tuyenubuntu/aicabinet/cabinet_cabin_1/Portal_Cabin_1/part_list_cabin1.xlsx

No. | Name | Part Number | Technical Doc | Brand or CO. | Unit | Qty/set | Qty cabin 1 | Spare part | Oder | Remark
1 | Sub 37 PIN board | DIN-37D-01 | DB37 Male | Adlink | PCS | 1 | 4 | 0 | 4
2 | D-Sub Cables | 976-ACL-10137-3MM | Cable 37 PIN | Adlink | PCS | 1 | 4 | 0 | 4
3 | Basler camera | a2A1920-51gcPRO | f 1/2.3" Effective Sensor Diagonal 7.9 mm | Basler | PCS | 1 | 4 | 0 | 4
4 | Cable GigE | 2200000622 | RJ-45, horizontal locking screws | Basler | PCS | 1 | 4 | 0 | 4
5 | Plug-in bridge | 3030161 | Plug-in bridge FBS 2-5, pitch: 5.2 mm, color: red | Phoenix contact | PCS | 10 | 40 | 0 | 50 | Minimum order quantity: 50
6 | Power supply unit | 2909575 | 24VDC, push | Phoenix contact | PCS | 1 | 4 | 0 | 4
7 | Relay | 2966728 | 24DC/48DC/100 Series Solid State Interface Relay, 28.8 V ac/dc Control, DIN Rail Mount | Phoenix contact | PCS | 4 | 16 | 3 | 13
8 | Terminal Blue | 3209523 | PT 2,5 BU - Feed-through terminal block | Phoenix contact | PCS | 2 | 8 | 0 | 1 box | Minimum order quantity: 50
9 | Terminal Gray | 3209510 | PT 2,5 - Feed-through terminal block | Phoenix contact | PCS | 17 | 68 | 0 | 2 box
10 | Terminal Pe | 3209536 | PT 2,5-PE - Ground terminal | Phoenix contact | PCS | 2 | 8 | 0 | 1 box
11 | End cover | 3030417 | color:Gray,D-ST 2,5 | Phoenix contact | PCS | 5 | 20 | 0 | 1 box
12 | End bracket | 3022218 | DIN rail, gray | Phoenix contact | PCS | 4 | 16 | 0 | 2 box
13 | Rail | 801733 | DIN Rail (2m) | Phoenix contact | m | 0.4 | 1.6 | 0 | 1 bar | 2m/bar
14 | Cable duct | 3240188 | CD 25X40 (2m) | Phoenix contact | m | 1.1 | 4.4 | 0 | 3 bar | 2m/bar
15 | Alamp/Signal | ST45L-BZ-2-24-RG | signalling column; LED; red/green; 24VDC; IP23 | QLINGHT | PCS | 1 | 4 | 2 | 2
16 | Circuit breaker | EZ9F34210 | MCB C10A | Schneider | PCS | 1 | 4 | 0 | 4
17 | Cabinet | NSYS3D3315P | 300x300x150 | Schnieder | PCS | 1 | 4 | 0 | 4
18 | Key Switch | 3SU1000-4BF01-0AA0 | key-operated switch, 22 mm, round, plastic, with 2 keys, 2 switch positions O-I, latching, actuating angle 90° | Siemens | PCS | 1 | 4 | 0 | 4
19 | Holder | 3SU1500-0AA10-0AA0 | 30,00 x 40,00 x 25,00 | Siemens | PCS | 1 | 4 | 0 | 4
20 | NO contact | 3SU1400-1AA10-1BA0 | 1 NO | Siemens | PCS | 1 | 4 | 0 | 5 | Minimun order quantity: 5
21 | Monitor |  |  |  | PCS | 1 | 4 | 0 | 4
22 | Vesa monitor |  |  |  | PCS | 1 | 4 | 0 | 4
