tuyenubuntu/aicabinet/cabinet_cabin_1/Component/board/board e.sldasm

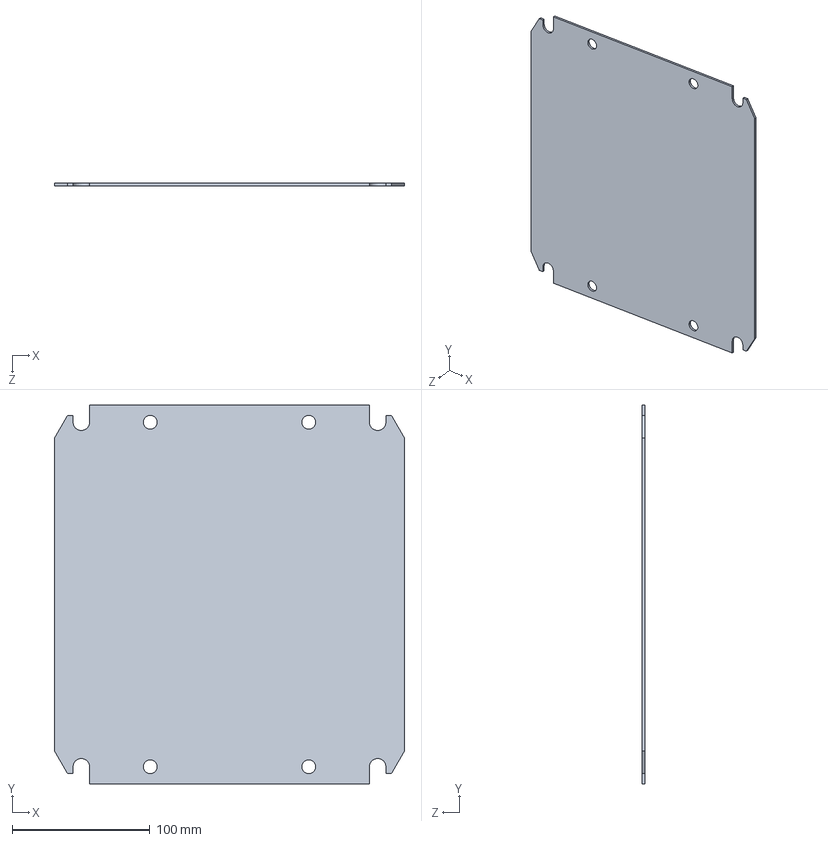
[picture p1: CAD file, 2024-05-25]
cabinet_cabin_1/Component/board/board e.sldasm
254.0 x 275.0 x 2.00 mm
