tuyenubuntu/aicabinet/cabinet_cabin_1/Component/Power_Supply/power supply.SLDASM

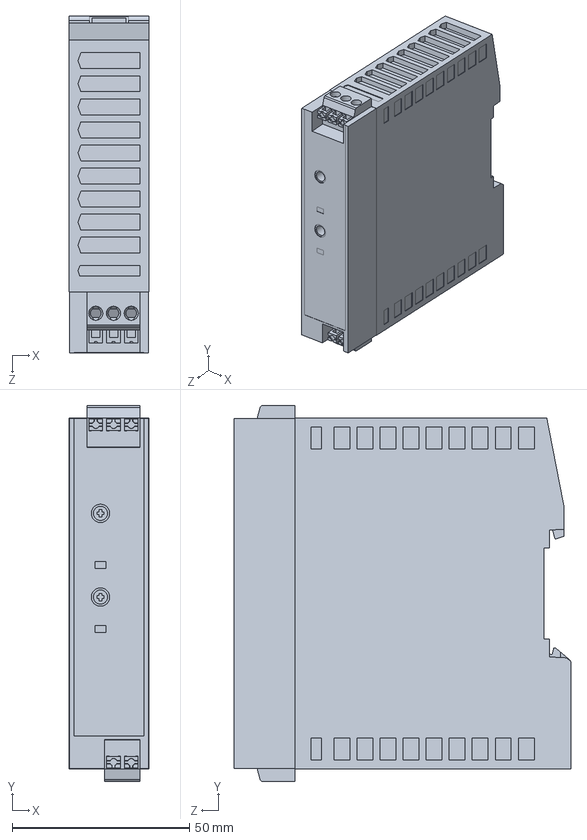
[picture p2: CAD file, 2024-05-25]
cabinet_cabin_1/Component/Power_Supply/power supply.SLDASM
22.5 x 106.0 x 95.0 mm
