tuyenubuntu/aicabinet/cabinet_cabin_1/Component/relay_soil/relay.SLDASM

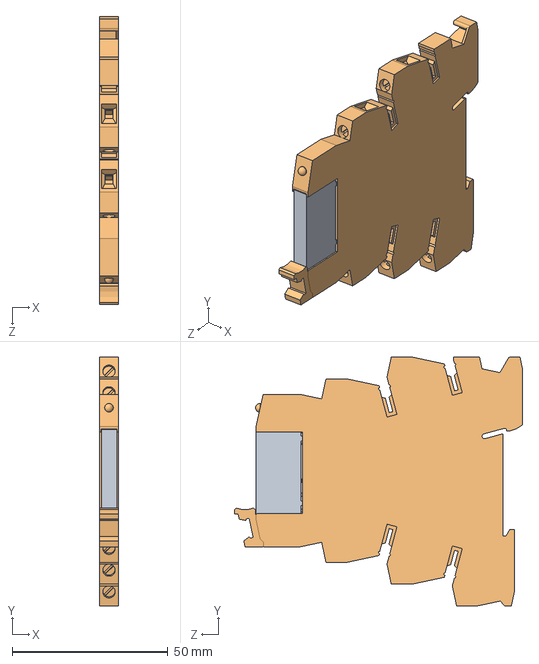
[picture p3: CAD file, 2024-05-25]
cabinet_cabin_1/Component/relay_soil/relay.SLDASM
6.10 x 80.0 x 92.6 mm
