tuyenubuntu/aicabinet/cabinet_cabin_1/Component/Sub_37_pin/DIN DB 37.SLDASM

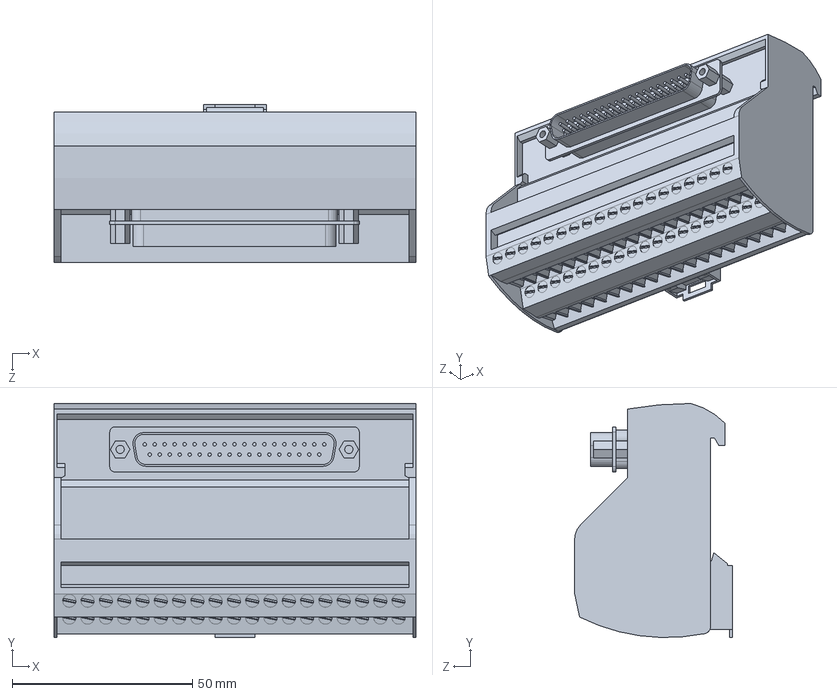
[picture p4: CAD file, 2024-05-25]
cabinet_cabin_1/Component/Sub_37_pin/DIN DB 37.SLDASM
100.5 x 65.0 x 43.8 mm
