tuyenubuntu/aicabinet/cabinet_cabin_1/Component/terminal_block/terminal_PE.SLDASM

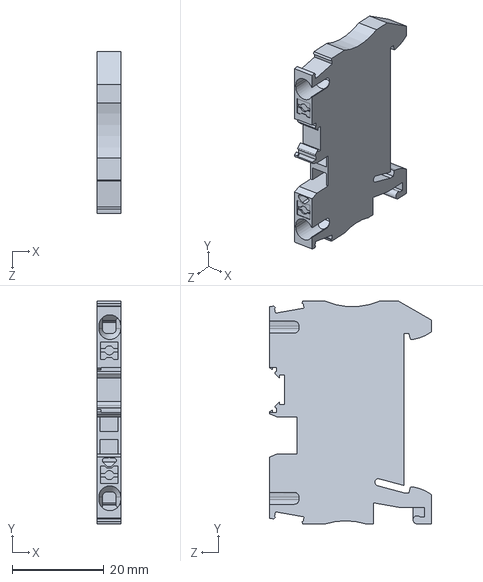
[picture p5: CAD file, 2024-05-25]
cabinet_cabin_1/Component/terminal_block/terminal_PE.SLDASM
5.15 x 48.6 x 35.3 mm
