tuyenubuntu/aicabinet/Cabinet_cabin_1_AL12/cabinet_AI_12.SLDASM

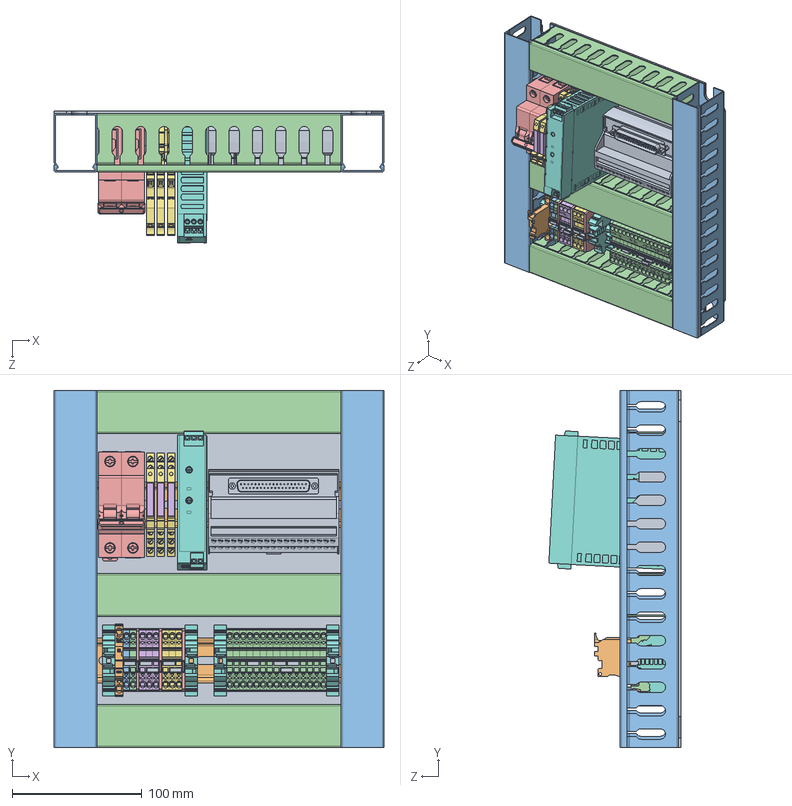
[picture p6: CAD file, 2024-05-25]
Cabinet_cabin_1_AL12/cabinet_AI_12.SLDASM
254.0 x 275.0 x 101.9 mm
AE_1036_500__2__3
DIN_rail x 2
cable_duct_275 x 2
cable_duct_188 x 3
Schneidr_MCB_C10A
2909575_PART1.stp
2900676_PART1.stp
3209510_PART1^3209510_terminal_gray
Copy of 3209510_PART1^cabinet_AI_12 x 16
end_cover x 3
Terminal_Bu x 3
terminalpe x 3
end x 4
jumper2.5 x 9
