tuyenubuntu/aicabinet/cabinet_cabin_1/cabinet/Drawing_prc/sheetdetail.SLDASM

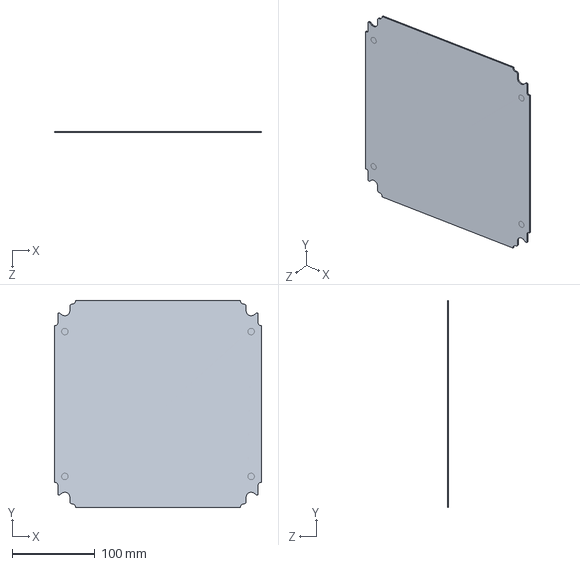
[picture p7: CAD file, 2024-05-25]
cabinet_cabin_1/cabinet/Drawing_prc/sheetdetail.SLDASM
250.0 x 250.0 x 1.80 mm
