tuyenubuntu/aicabinet/cabinet_cabin_1/cabinet/NSYS3D3315P_3D.SLDASM

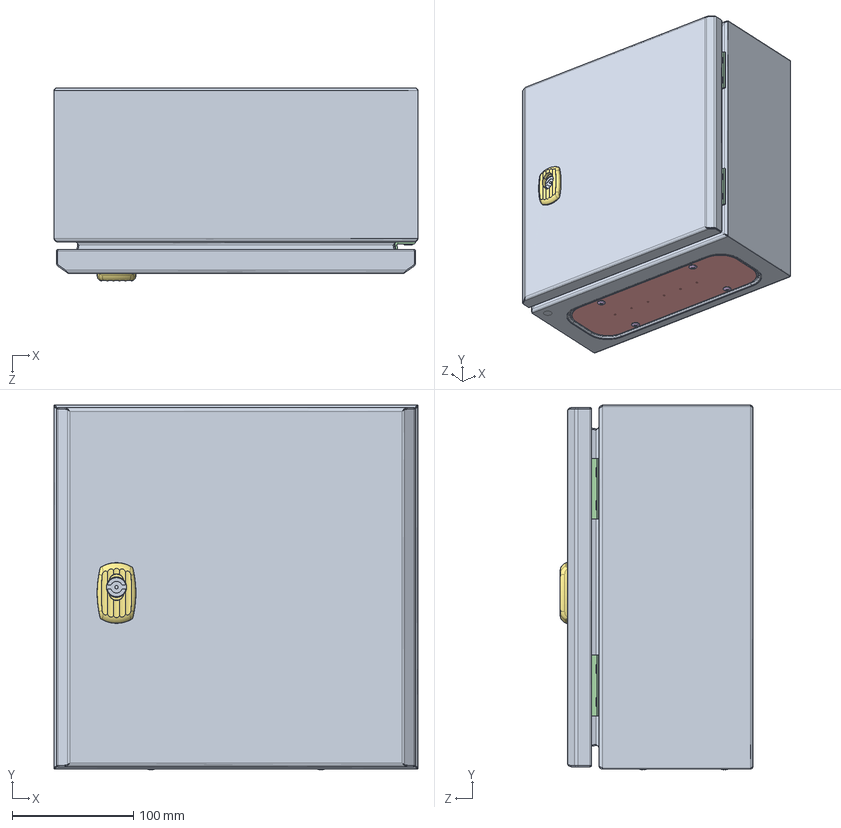
[picture p8: CAD file, 2024-05-25]
cabinet_cabin_1/cabinet/NSYS3D3315P_3D.SLDASM
300.0 x 300.5 x 159.0 mm
51140584-S_300X300X150_1LAST_VE_AF0.stp
51140583-S01_1LAST_VERSION_1__3_AF8.stp
51140583-S01_1LAST_VERSION_1__3_AF9.stp
51140583-S01_1LAST_VERSION_1__3_AF10.stp
51140583-S01_1LAST_VERSION_1__3_AF11.stp
51140582-S01_1LAST_VERSION_1__7.stp x 3
ENN4584AS_300X300_1LAST_VERSION.stp
ENN2538A_M6X17_1LAST_VERSION__7.stp
51140547-S_300X300_1LAST_VERSIO.stp
51140547-S1_300X300_1LAST_VERSI.stp
51140590-S_1LAST_VERSION_1_2.stp x 2
ENN0059A-S_1LAST_VERSION_1_2__7.stp x 2
51140599_PPC245X80_1LAST_VERSIO.stp
ENN5120805644_1LAST_VERSION_1_7.stp x 4
51140856-SIMP_1LAST_VERSION_1_7.stp
ENN0052A-SIMP_1LAST_VERSION_1_7.stp
ENN0263A-SIMP_1LAST_VERSION_1_7.stp
ENN0284A-SIMP_1LAST_VERSION_1_7.stp
ENN0827A-SIMP_1LAST_VERSION_1_7.stp
ENN5120807239-SIMP_1LAST_VERS_7.stp
