tuyenubuntu/aicabinet/cabinet_cabin_1/Component/board/M16 x 1.5 Cable Gland Assembly.stp

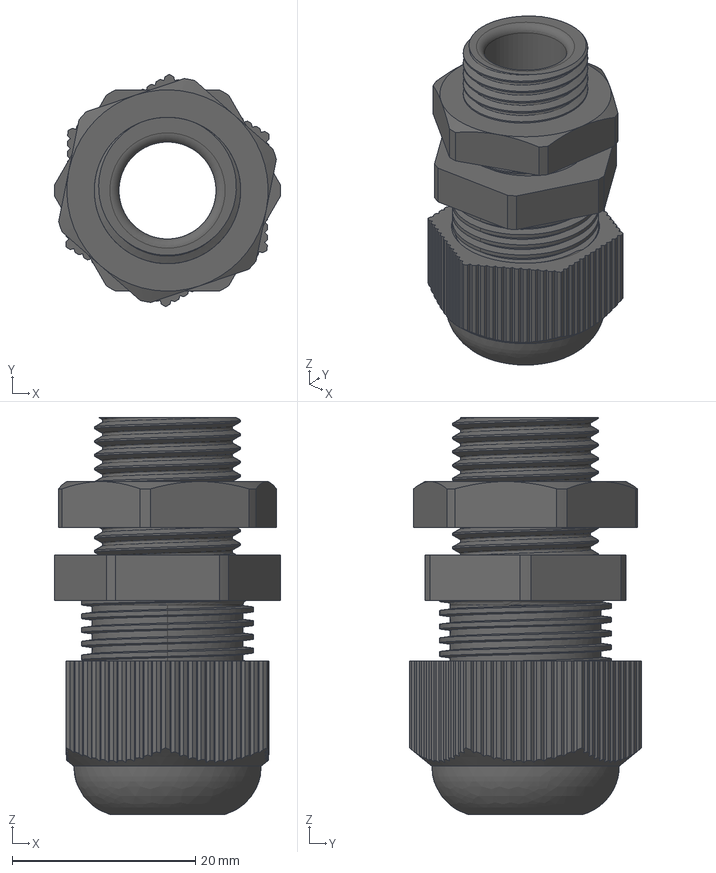
[picture p9: CAD file, 2024-05-25]
cabinet_cabin_1/Component/board/M16 x 1.5 Cable Gland Assembly.stp
24.7 x 25.4 x 43.4 mm
Nut
Compression Nut
