tuyenubuntu/aicabinet/cabinet_cabin_1/Component/Circuit_breaker/MCBA10.SLDASM

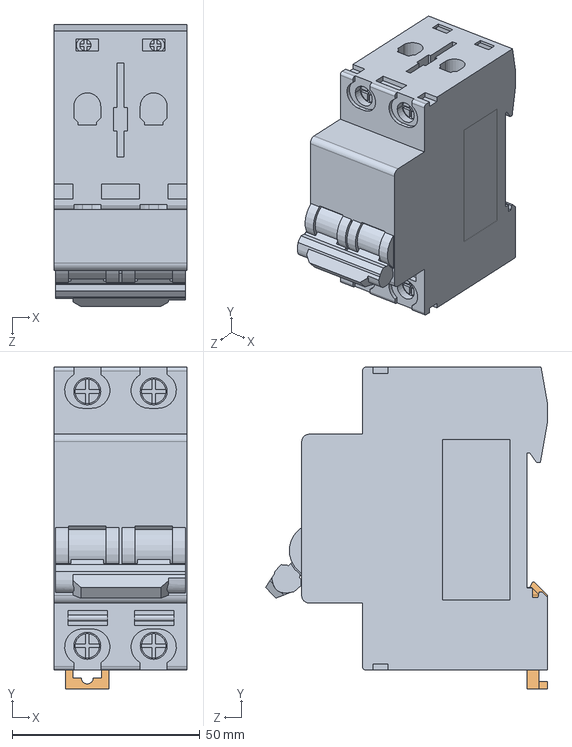
[picture p10: CAD file, 2024-05-25]
cabinet_cabin_1/Component/Circuit_breaker/MCBA10.SLDASM
35.4 x 85.8 x 75.1 mm
EZ9F32240.stp
EZ9F32240-1.stp
