tuyenubuntu/aicabinet/Mount_camera/Mount_camera_OD/asb.SLDASM

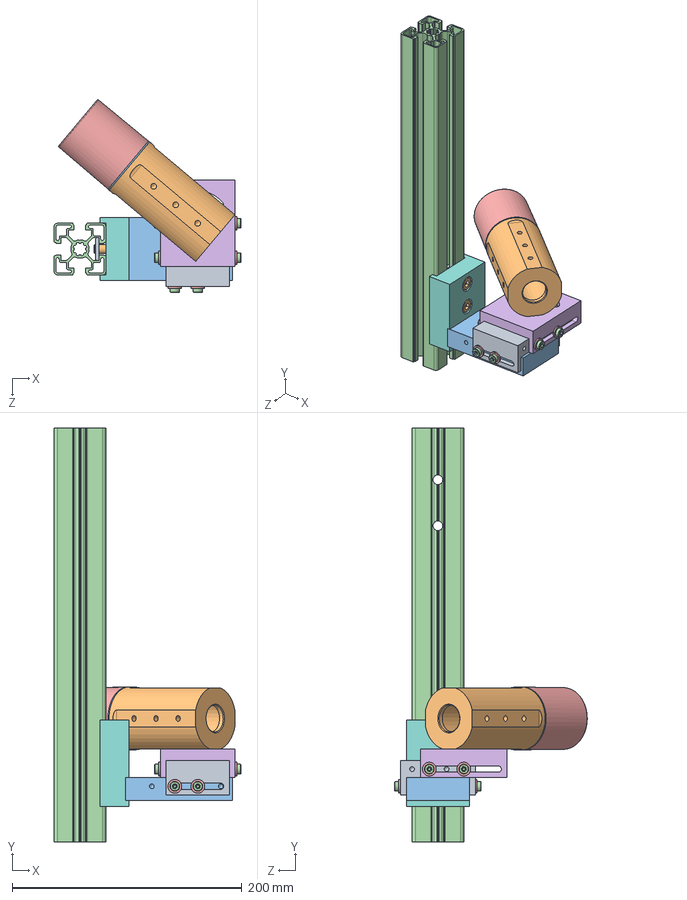
[picture p11: CAD file, 2024-05-25]
Mount_camera/Mount_camera_OD/asb.SLDASM
162.5 x 360.0 x 167.5 mm
IPE Compact Housing Body Long_CG.step
D55 seal.step
Perfil 45X45_Long
2200000710 Basler IP-Housing Lens Tube 50mm
DIN 6912 - M6 x 10 --- 4.5N x 2
Part1ip
nut x 2
DIN 6912 - M8 x 25 --- 18N x 2
Part1ipp
DIN 6912 - M5 x 10 --- 5.8N x 8
DIN 6902-A5.5 x 8
