tuyenubuntu/aicabinet/Cabinet_cabin_1_AL12/Component/terminal_block/shiel.SLDASM

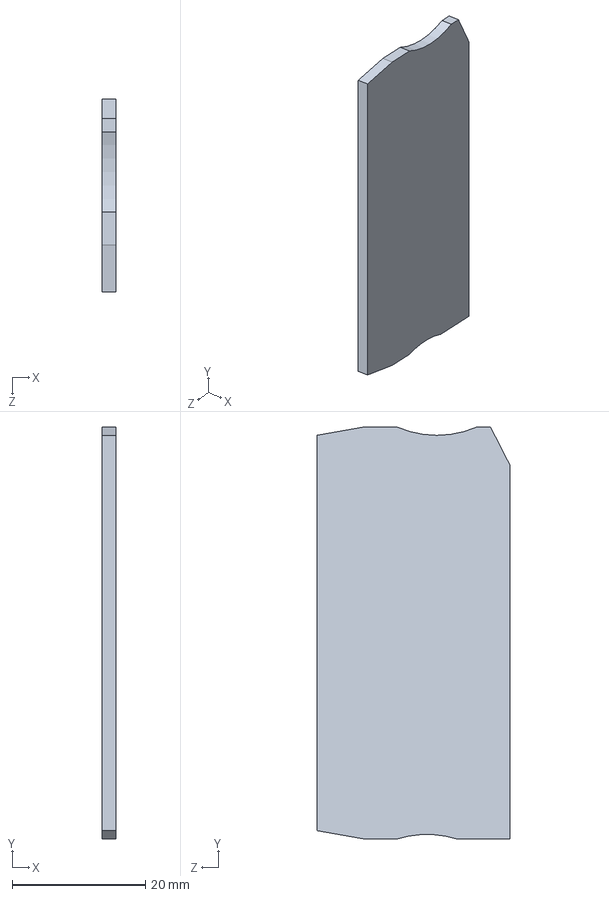
[picture p12: CAD file, 2024-05-25]
Cabinet_cabin_1_AL12/Component/terminal_block/shiel.SLDASM
2.10 x 61.9 x 29.0 mm
