tuyenubuntu/aicabinet/cabinet_cabin_1/Component/terminal_block/jumper.SLDASM

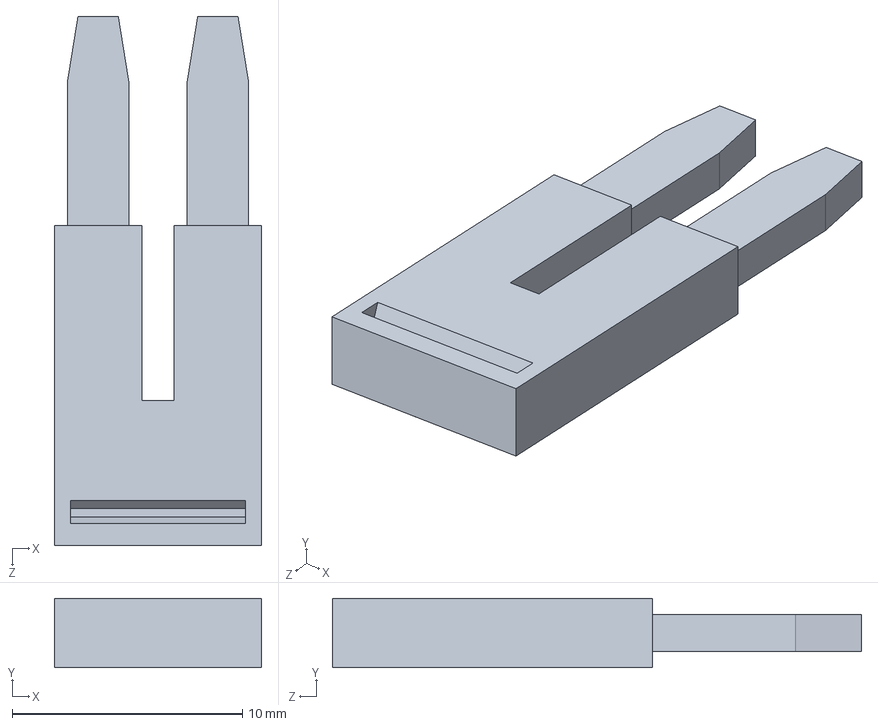
[picture p13: CAD file, 2024-05-25]
cabinet_cabin_1/Component/terminal_block/jumper.SLDASM
9.00 x 3.00 x 23.0 mm
