tuyenubuntu/aicabinet/Mount_camera/Mount_camera_OD/Mount_camera.SLDASM

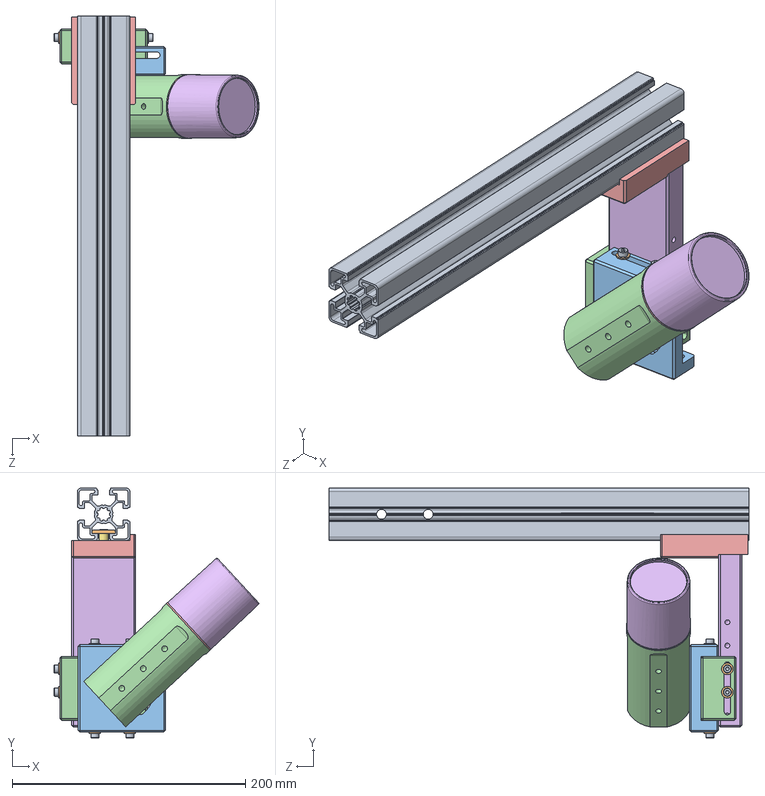
[picture p14: CAD file, 2024-05-25]
Mount_camera/Mount_camera_OD/Mount_camera.SLDASM
175.6 x 214.2 x 360.0 mm
part5ip
nut x 2
IPE Compact Housing Body Long_CG.step
D55 seal.step
2200000710 Basler IP-Housing Lens Tube 50mm
DIN 912 M8 x 16 --- 16N x 2
DIN 912 M6 x 12 --- 12N x 2
DIN 912 M4 x 16 --- 16N x 8
DIN 6902-A4.55 x 8
BS EN ISO 4762 M6 x 25 - 25N x 2
