tuyenubuntu/aicabinet/cabinet_cabin_1/AL_OG/M16 x 1.5 Cable Gland Assembly.stp.SLDPRT

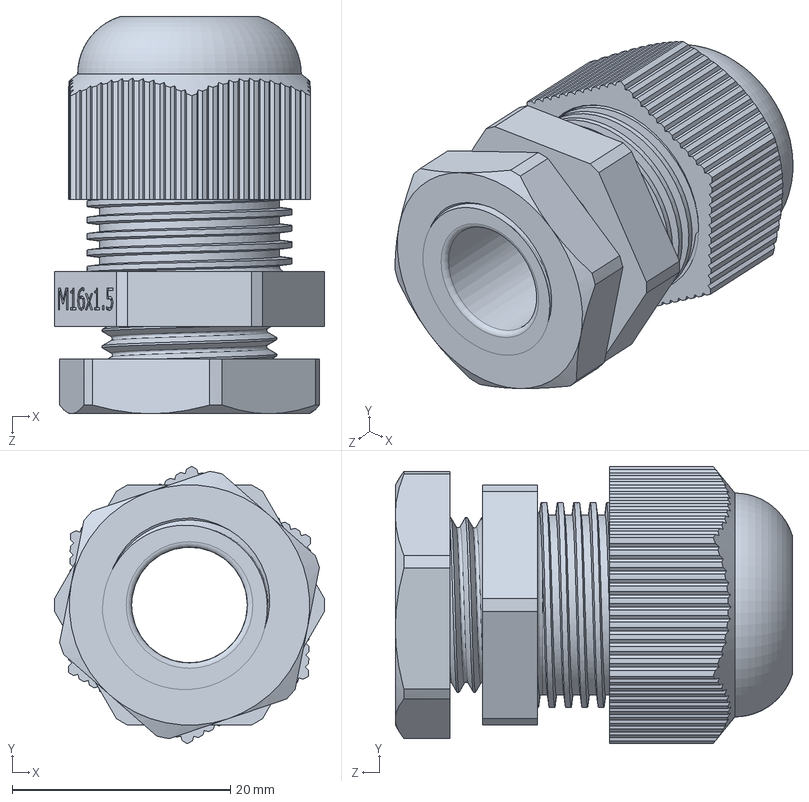
[picture p15: CAD file, 2024-05-25]
cabinet_cabin_1/AL_OG/M16 x 1.5 Cable Gland Assembly.stp.SLDPRT
24.7 x 25.4 x 36.4 mm
