tuyenubuntu/aicabinet/Cabinet_cabin_1_AL12/env/cabinet AI Camera layout.SLDASM

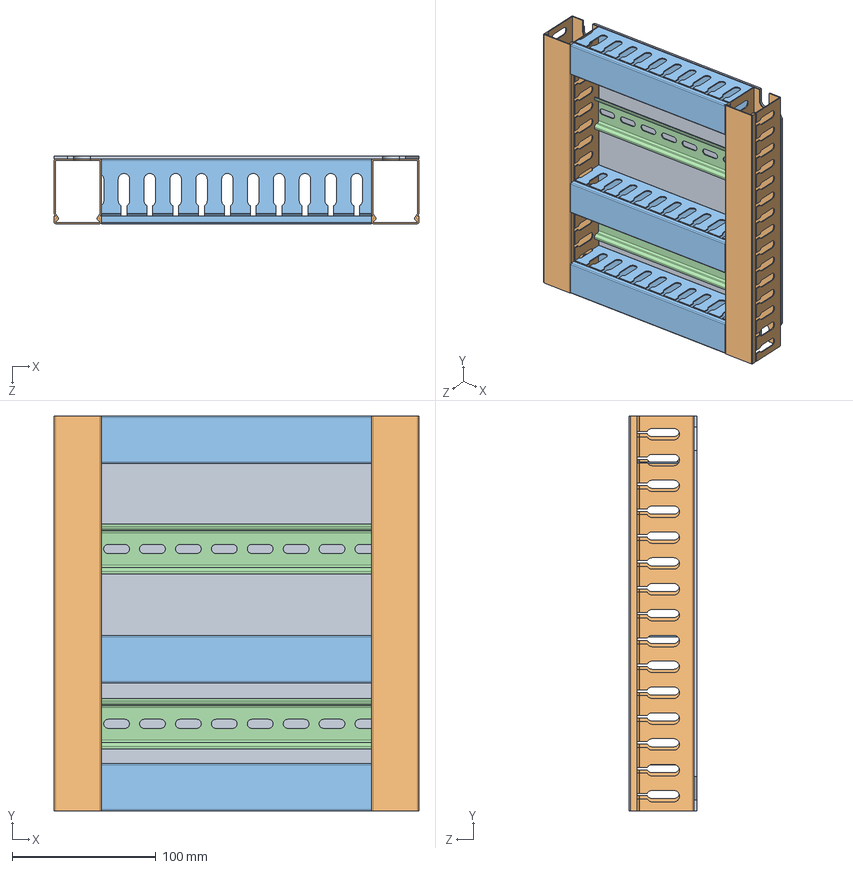
[picture p16: CAD file, 2024-05-25]
Cabinet_cabin_1_AL12/env/cabinet AI Camera layout.SLDASM
254.0 x 275.0 x 47.0 mm
AE_1036_500__2__3
cable duct long x 2
cable duct short x 3
DIN_rail x 2
