tuyenubuntu/aicabinet/cabinet_cabin_1/Component/Circuit_breaker/cb sh.SLDPRT

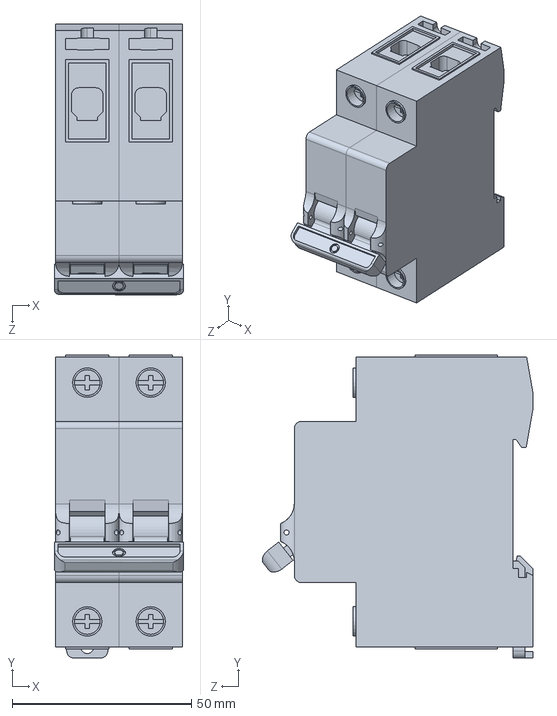
[picture p17: CAD file, 2024-05-25]
cabinet_cabin_1/Component/Circuit_breaker/cb sh.SLDPRT
36.0 x 84.5 x 75.4 mm
