tuyenubuntu/aicabinet/cabinet_cabin_1/Component/Rail/Riel Din500mm.SLDPRT

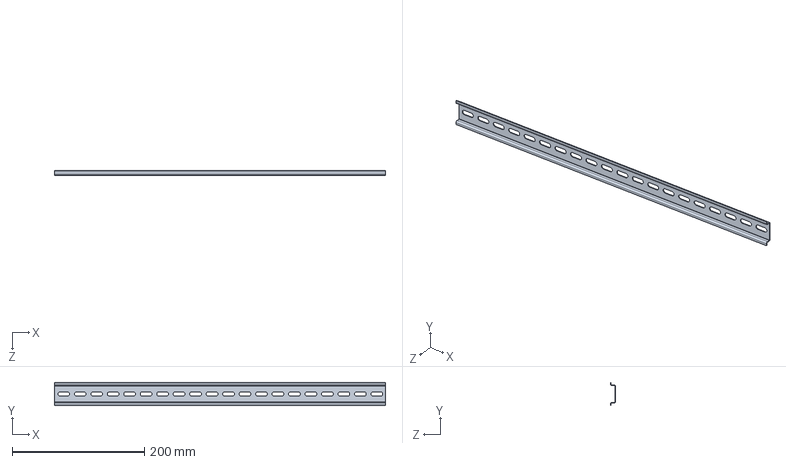
[picture p18: CAD file, 2024-05-25]
cabinet_cabin_1/Component/Rail/Riel Din500mm.SLDPRT
500.0 x 35.0 x 7.50 mm
