tuyenubuntu/aicabinet/Cabinet_cabin_1_AL12/Component/Cable_duct/MD-1.5L-1.7-R.SLDPRT

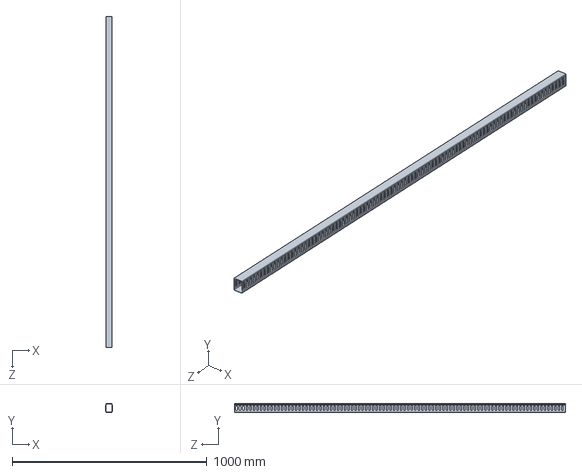
[picture p19: CAD file, 2024-05-25]
Cabinet_cabin_1_AL12/Component/Cable_duct/MD-1.5L-1.7-R.SLDPRT
33.0 x 45.0 x 1700.0 mm
