tuyenubuntu/aicabinet/Cabinet_cabin_1_AL12/Component/Rail_DIN/DIN_rail.SLDPRT

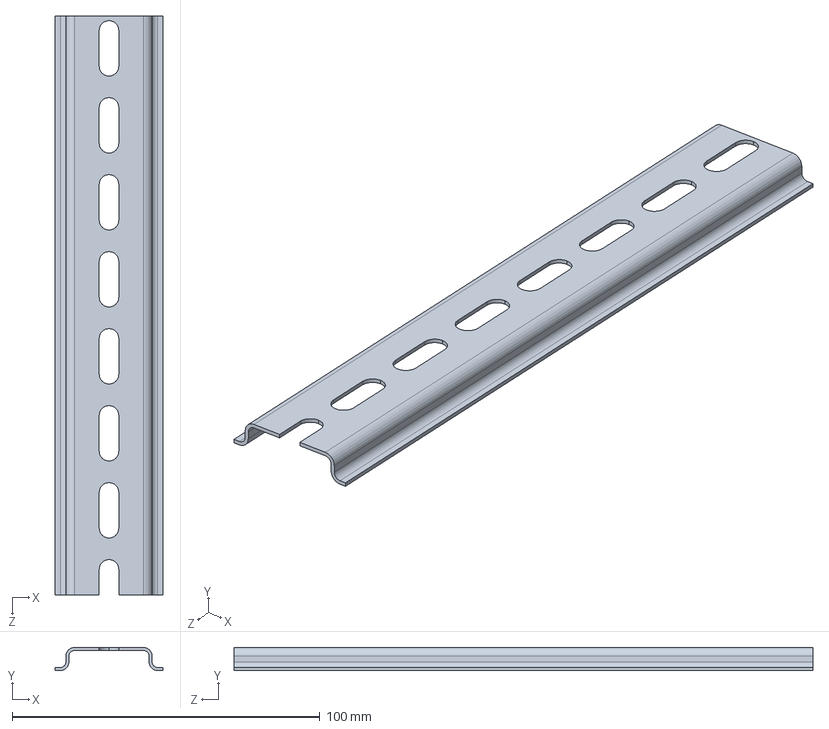
[picture p20: CAD file, 2024-05-25]
Cabinet_cabin_1_AL12/Component/Rail_DIN/DIN_rail.SLDPRT
35.0 x 7.50 x 188.0 mm
