tuyenubuntu/aicabinet/Mount_camera/Mount_camera_FN/Part3.SLDPRT

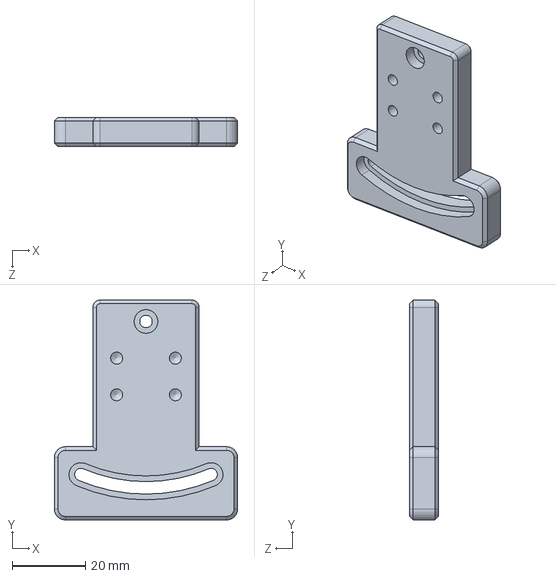
[picture p21: CAD file, 2024-05-25]
Mount_camera/Mount_camera_FN/Part3.SLDPRT
50.0 x 60.0 x 8.00 mm
