tuyenubuntu/aicabinet/Mount_camera/Mount_camera_OD/part1.SLDPRT

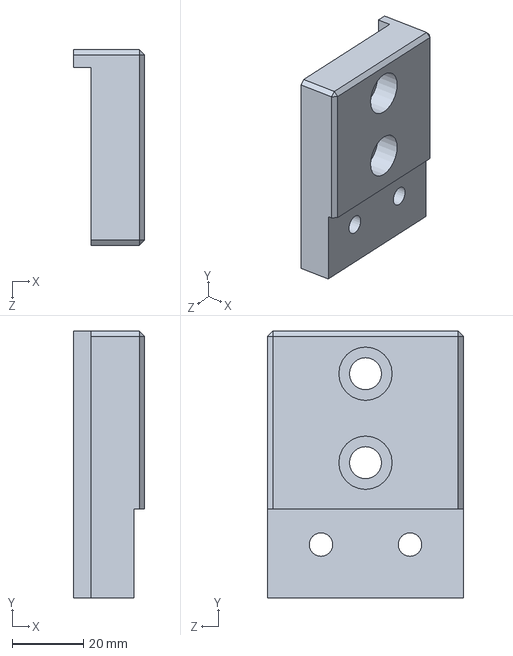
[picture p22: CAD file, 2024-05-25]
Mount_camera/Mount_camera_OD/part1.SLDPRT
20.0 x 75.0 x 55.0 mm
