tuyenubuntu/aicabinet/cabinet_cabin_1/Component/Rail/Riel Din200mm.SLDPRT

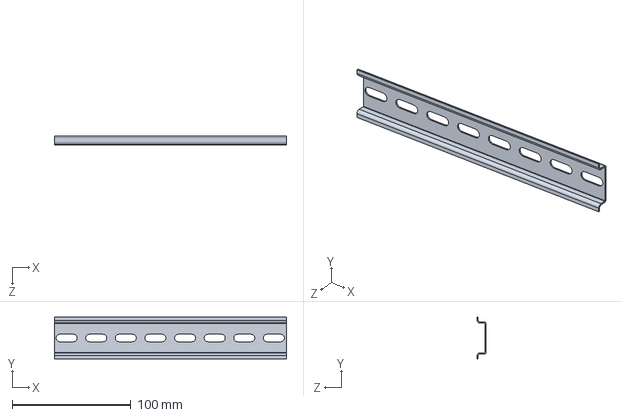
[picture p23: CAD file, 2024-05-25]
cabinet_cabin_1/Component/Rail/Riel Din200mm.SLDPRT
195.0 x 35.0 x 7.50 mm
