tuyenubuntu/aicabinet/cabinet_cabin_1/Component/terminal_block/end_cover.SLDPRT

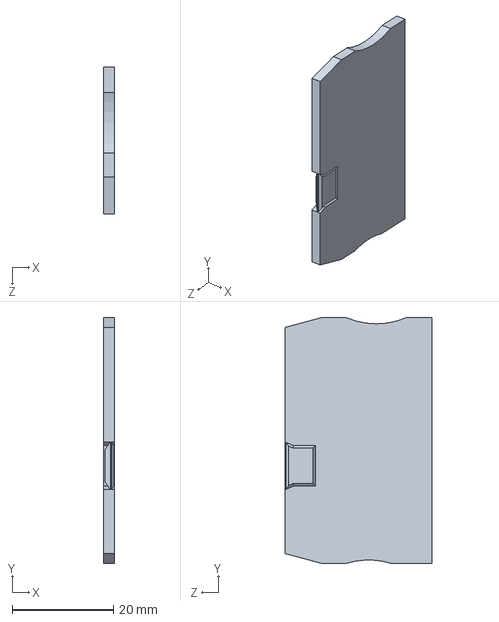
[picture p24: CAD file, 2024-05-25]
cabinet_cabin_1/Component/terminal_block/end_cover.SLDPRT
2.20 x 48.6 x 29.0 mm
