tuyenubuntu/aicabinet/Cabinet_cabin_1_AL12/Component/Cable_duct/cable_duct_188.SLDPRT

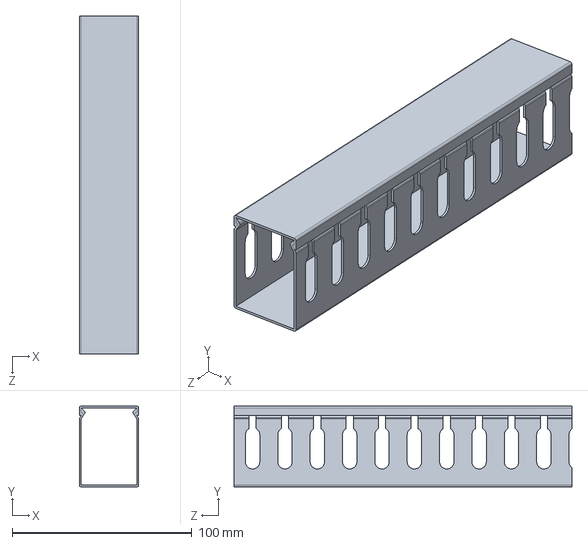
[picture p25: CAD file, 2024-05-25]
Cabinet_cabin_1_AL12/Component/Cable_duct/cable_duct_188.SLDPRT
33.0 x 45.0 x 188.0 mm
