tuyenubuntu/aicabinet/Cabinet_cabin_1_AL12/Component/terminal_block/terminalpe.SLDPRT

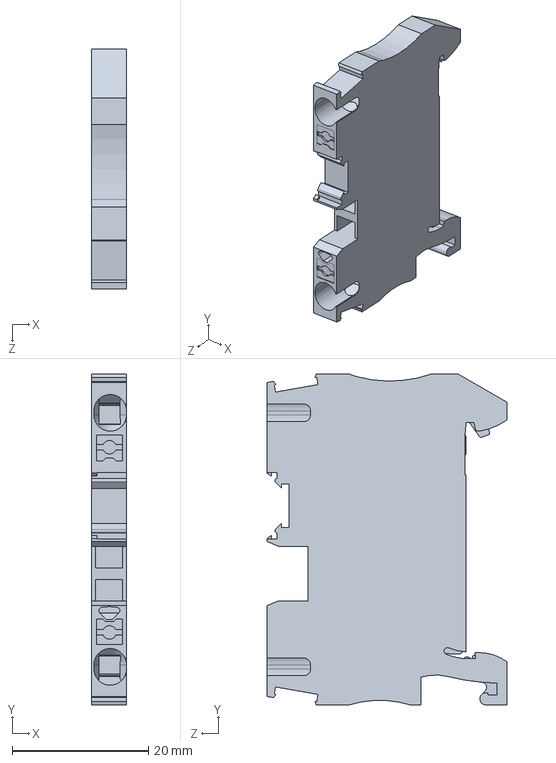
[picture p26: CAD file, 2024-05-25]
Cabinet_cabin_1_AL12/Component/terminal_block/terminalpe.SLDPRT
5.15 x 48.6 x 35.2 mm
