tuyenubuntu/aicabinet/Cabinet_cabin_1_AL12/env/cable duct long.SLDPRT

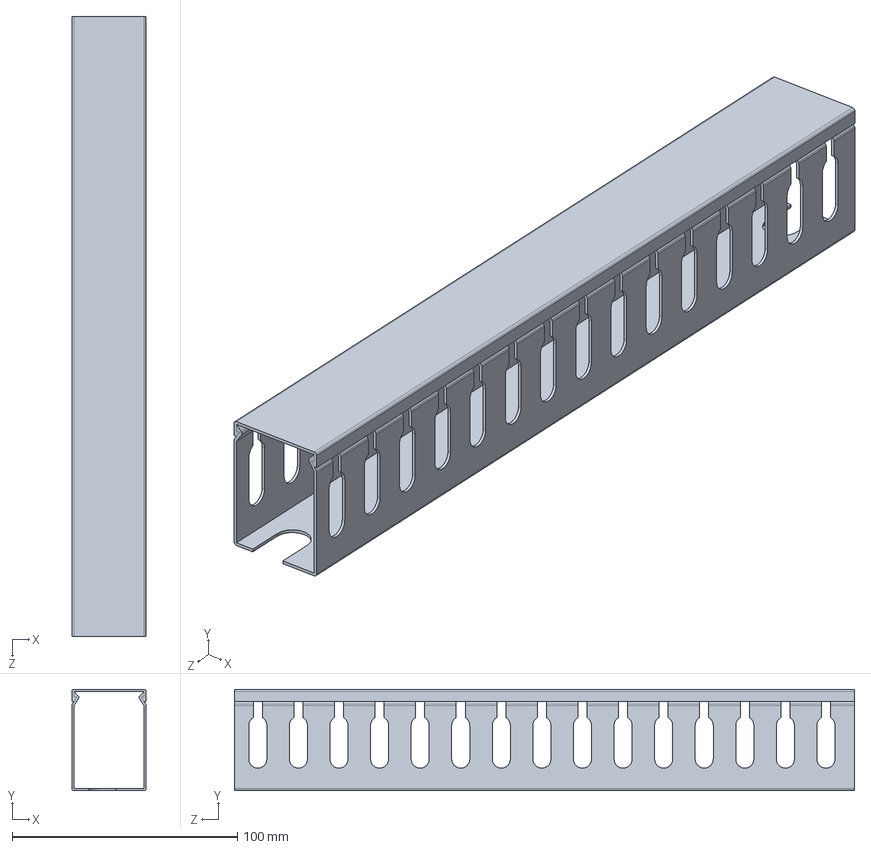
[picture p27: CAD file, 2024-05-25]
Cabinet_cabin_1_AL12/env/cable duct long.SLDPRT
33.0 x 45.0 x 275.0 mm
