tuyenubuntu/aicabinet/Mount_camera/Mount_camera_FN/Part2.SLDPRT

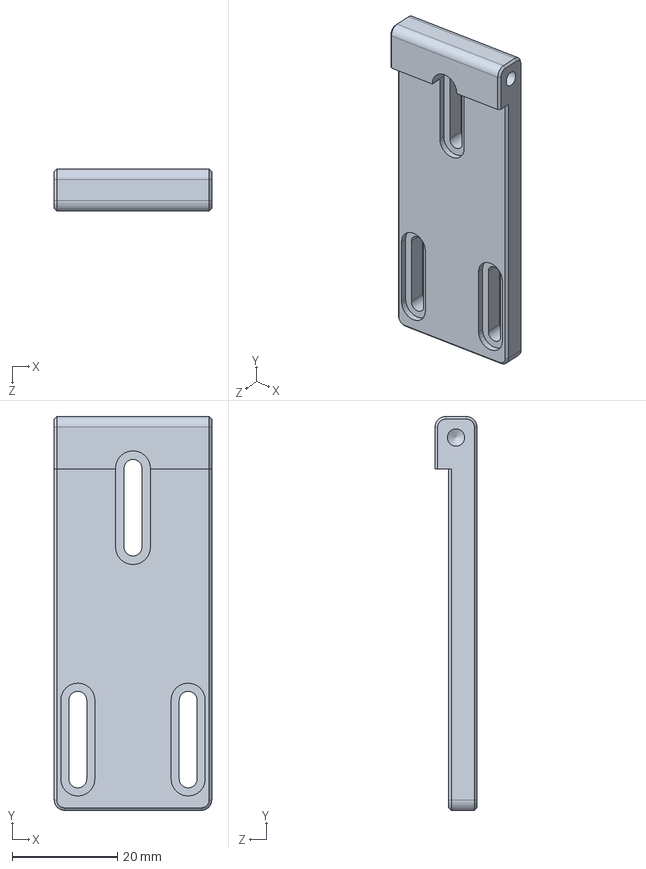
[picture p28: CAD file, 2024-05-25]
Mount_camera/Mount_camera_FN/Part2.SLDPRT
30.0 x 75.0 x 8.00 mm
