tuyenubuntu/aicabinet/cabinet_cabin_1/AL_OG/sheet_metalr.SLDPRT

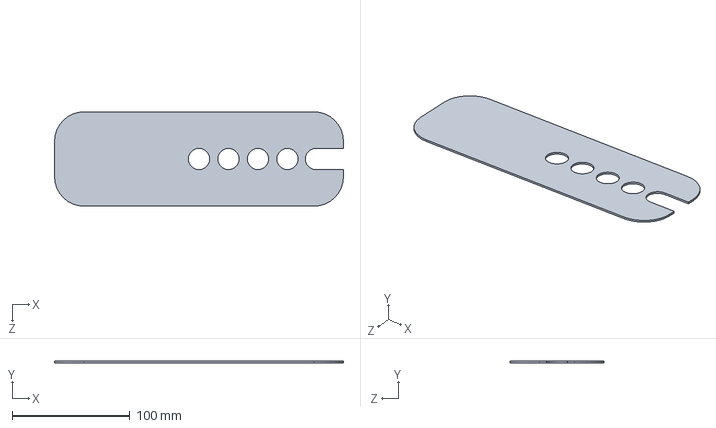
[picture p29: CAD file, 2024-05-25]
cabinet_cabin_1/AL_OG/sheet_metalr.SLDPRT
245.0 x 1.50 x 80.0 mm
