tuyenubuntu/aicabinet/cabinet_cabin_1/Component/board/pxc_1050017_01_00_ZB-5-LGS-FORTL-ZAHLEN_3D.stp.SLDPRT

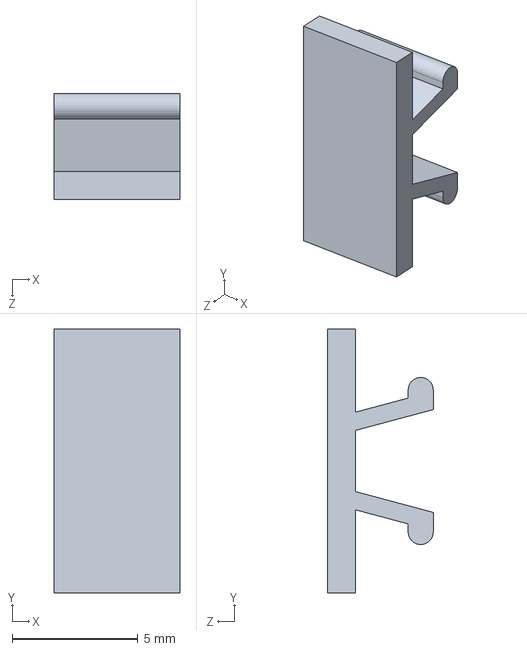
[picture p30: CAD file, 2024-05-25]
cabinet_cabin_1/Component/board/pxc_1050017_01_00_ZB-5-LGS-FORTL-ZAHLEN_3D.stp.SLDPRT
5.00 x 10.5 x 4.20 mm
