tuyenubuntu/aicabinet/Cabinet_cabin_1_AL12/env/DIN_rail.STEP

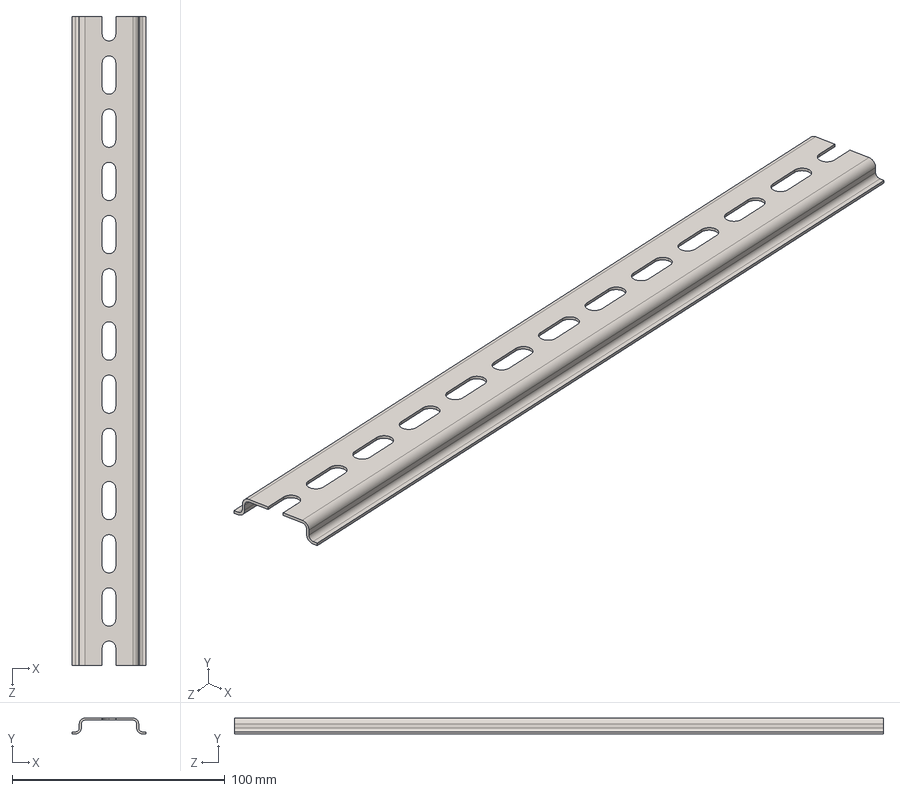
[picture p31: CAD file, 2024-05-25]
Cabinet_cabin_1_AL12/env/DIN_rail.STEP
35.0 x 7.50 x 305.0 mm
