tuyenubuntu/aicabinet/Mount_camera/Mount_camera_FN/Part2v.SLDPRT

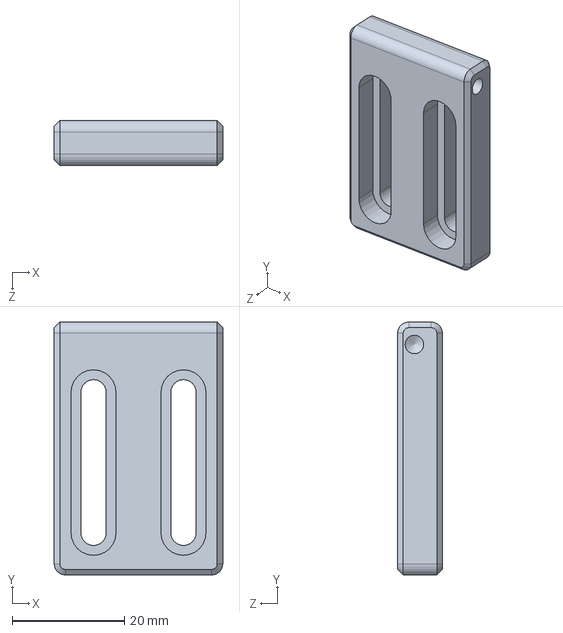
[picture p32: CAD file, 2024-05-25]
Mount_camera/Mount_camera_FN/Part2v.SLDPRT
30.0 x 45.0 x 8.00 mm
