tuyenubuntu/aicabinet/Mount_camera/Mount_camera_FN/Part1.SLDPRT

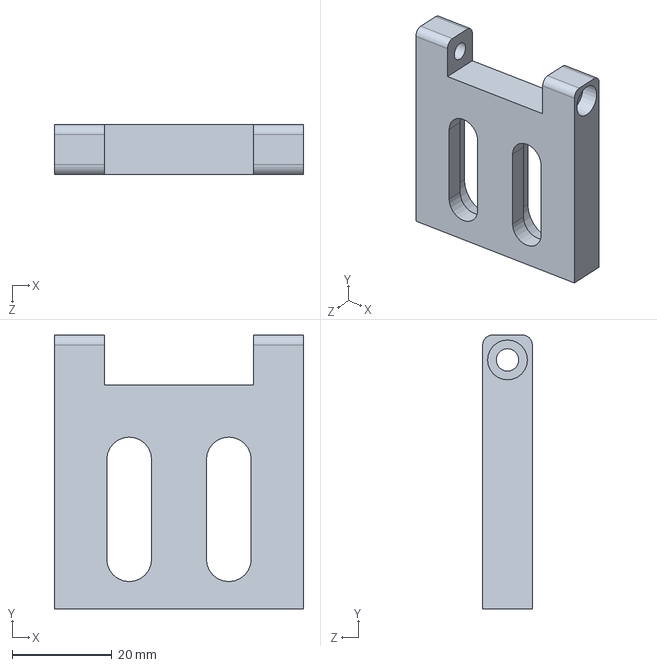
[picture p33: CAD file, 2024-05-25]
Mount_camera/Mount_camera_FN/Part1.SLDPRT
50.0 x 55.0 x 10.0 mm
