tuyenubuntu/aicabinet/Mount_camera/Mount_camera_OD/Part3.SLDPRT

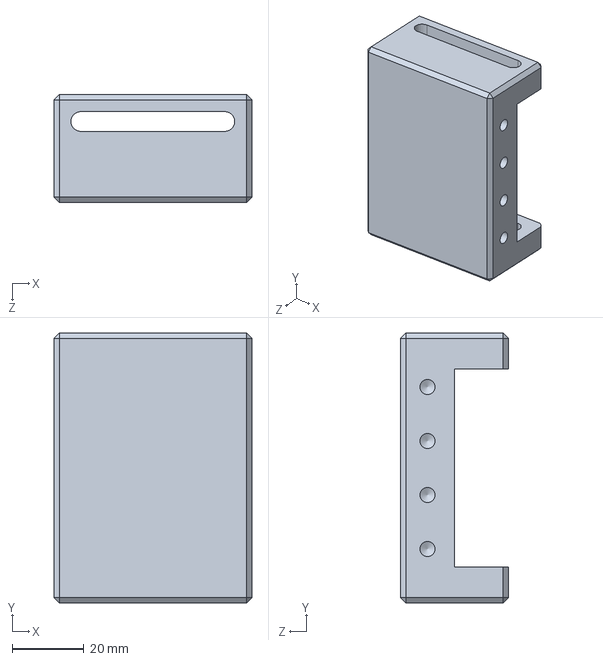
[picture p34: CAD file, 2024-05-25]
Mount_camera/Mount_camera_OD/Part3.SLDPRT
55.0 x 75.0 x 30.0 mm
