tuyenubuntu/aicabinet/Mount_camera/Mount_camera_FN/Perfil 45X45.SLDPRT

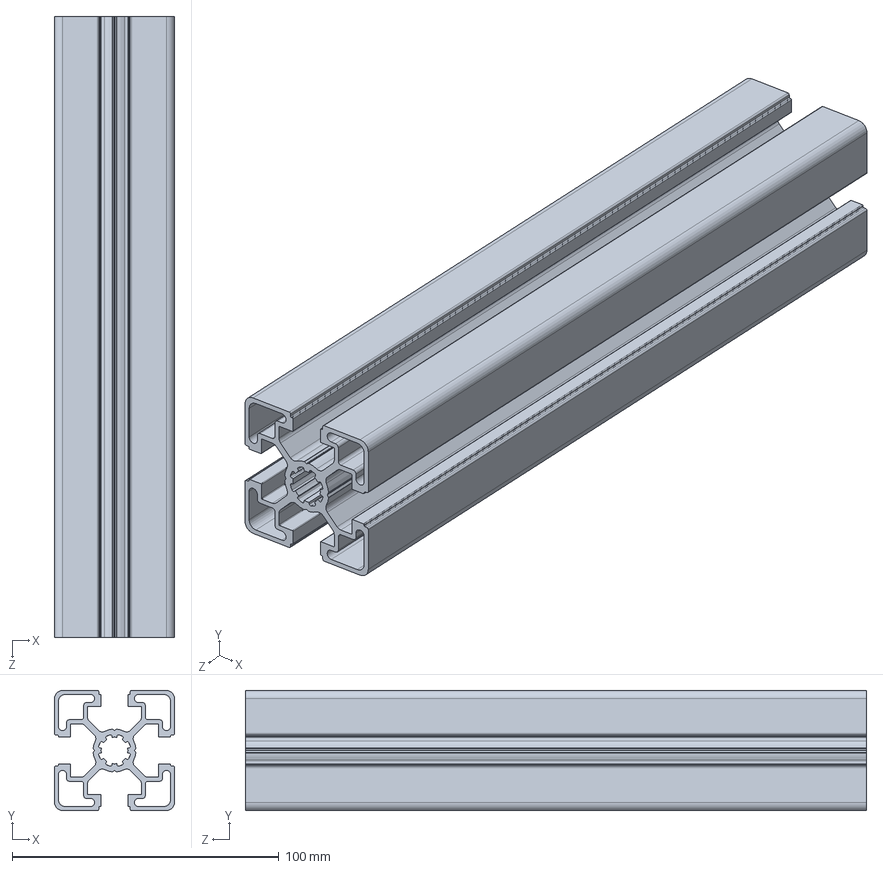
[picture p35: CAD file, 2024-05-25]
Mount_camera/Mount_camera_FN/Perfil 45X45.SLDPRT
45.0 x 45.0 x 233.0 mm
