tuyenubuntu/aicabinet/Mount_camera/Mount_camera_OD/part5ip.SLDPRT

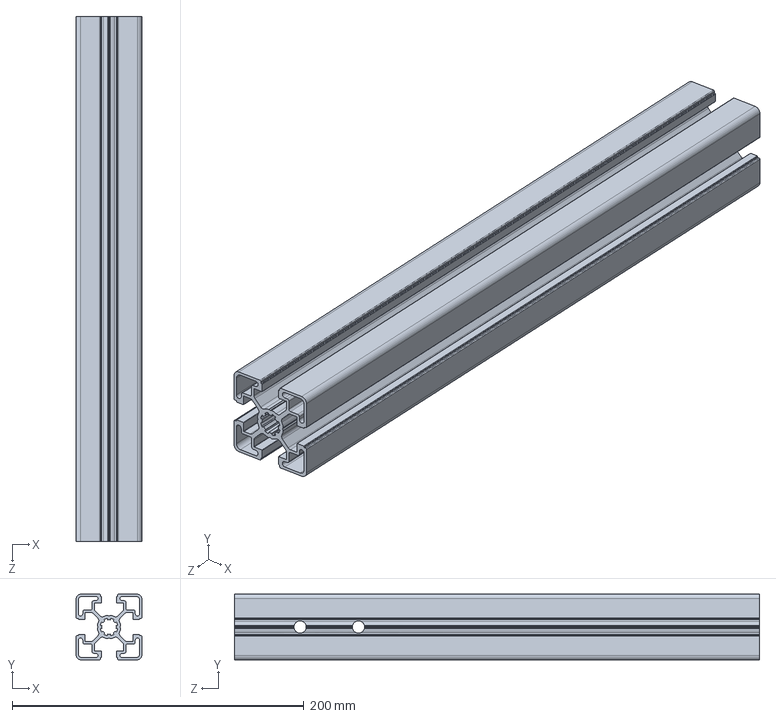
[picture p36: CAD file, 2024-05-25]
Mount_camera/Mount_camera_OD/part5ip.SLDPRT
45.0 x 45.0 x 360.0 mm
