tuyenubuntu/aicabinet/Cabinet_cabin_1_AL12/Component/terminal_block/end.SLDPRT

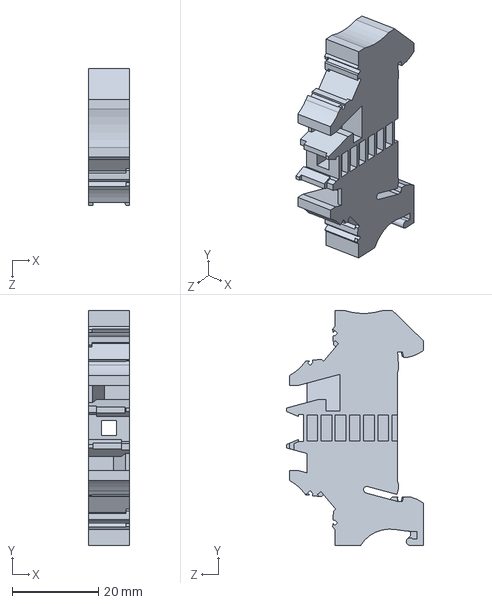
[picture p37: CAD file, 2024-05-25]
Cabinet_cabin_1_AL12/Component/terminal_block/end.SLDPRT
9.50 x 54.6 x 31.8 mm
