tuyenubuntu/aicabinet/Mount_camera/Mount_camera_OD/Part4.SLDPRT

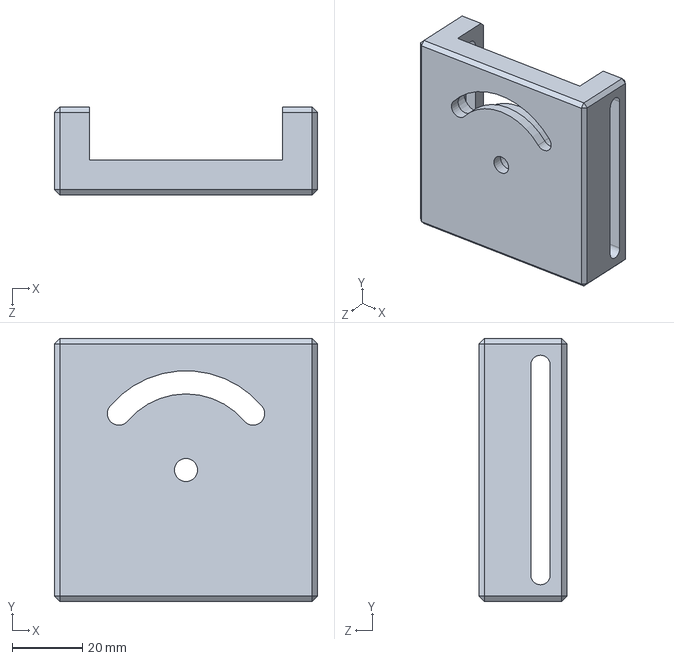
[picture p38: CAD file, 2024-05-25]
Mount_camera/Mount_camera_OD/Part4.SLDPRT
75.0 x 75.0 x 25.0 mm
