tuyenubuntu/aicabinet/Mount_camera/Mount_camera_OD/part2.SLDPRT

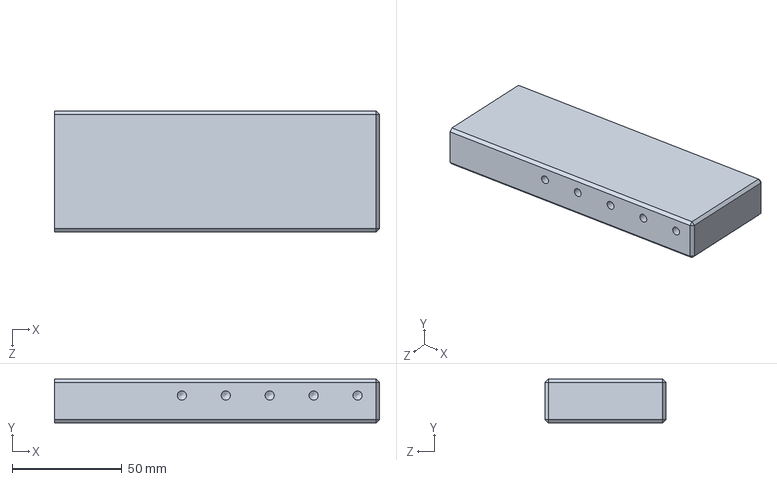
[picture p39: CAD file, 2024-05-25]
Mount_camera/Mount_camera_OD/part2.SLDPRT
148.0 x 20.0 x 55.0 mm
