tuyenubuntu/aicabinet/Cabinet_cabin_1_AL12/env/baser.SLDPRT

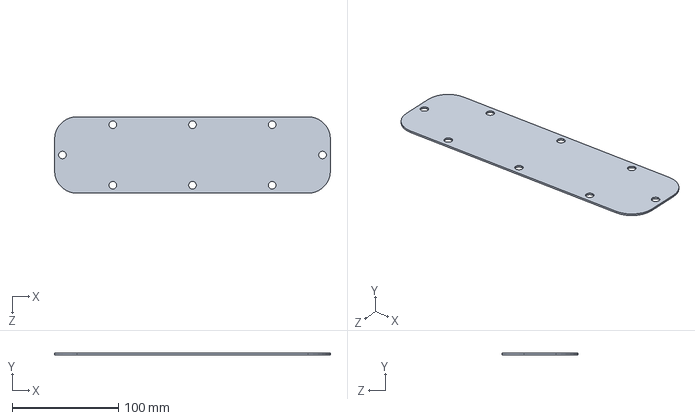
[picture p40: CAD file, 2024-05-25]
Cabinet_cabin_1_AL12/env/baser.SLDPRT
260.0 x 1.50 x 72.0 mm
