tuyenubuntu/aicabinet/(list of files, cad)

Other CAD files:
Cabinet_cabin_1_AL12/Component/terminal_block/terminal_gray.SLDASM
Cabinet_cabin_1_AL12/env/board e.sldasm
cabinet_cabin_1/AL_OG/relay.SLDASM
cabinet_cabin_1/Component/terminal_block/terminal_gray.SLDASM
cabinet_cabin_1/Component/terminal_block/terminal_blue.SLDASM
cabinet_cabin_1/AL_OG/terminal_gray.SLDASM
Cabinet_cabin_1_AL12/env/terminal_gray.SLDASM
Cabinet_cabin_1_AL12/env/relay.SLDASM
Cabinet_cabin_1_AL12/env/cabinet_AI_12.SLDASM
cabinet_cabin_1/AL_OG/sheet_borad.DWG
cabinet_cabin_1/cabinet/Drawing_prc/sheet.SLDPRT
cabinet_cabin_1/cabinet/NSYS3D3315P_3D-Simplified.stp
Mount_camera/Mount_camera_FN/Document&CAD/Mount_AI_Camera_FN.DWG
Mount_camera/Mount_camera_OD/Document&CAD/Mount_AI_Camera_OD.DWG
cabinet_cabin_1/AL_OG/NSYS3D3315P_3D-Simplified.stp
cabinet_cabin_1/Component/terminal_block/Terminal_Bu.SLDPRT
Cabinet_cabin_1_AL12/Component/Cable_duct/cable_duct_275.SLDPRT
cabinet_cabin_1/Component/terminal_block/jumper2.5.SLDPRT
Cabinet_cabin_1_AL12/Component/terminal_block/jumper2.5.SLDPRT
Cabinet_cabin_1_AL12/env/jumper2.5.SLDPRT
Cabinet_cabin_1_AL12/Component/terminal_block/Terminal_Bu.SLDPRT
Cabinet_cabin_1_AL12/env/cable_duct_275.SLDPRT
Mount_camera/Mount_camera_FN/Part1-HC-C-003UK.SLDPRT
Cabinet_cabin_1_AL12/env/cable duct short.SLDPRT
Mount_camera/Mount_camera_FN/Perfil 45X45_Long.SLDPRT
Cabinet_cabin_1_AL12/env/Terminal_Bu.SLDPRT
Cabinet_cabin_1_AL12/env/AE_1036_500__2__3.sldprt
cabinet_cabin_1/AL_OG/jumper2.5.SLDPRT
cabinet_cabin_1/AL_OG/Terminal_Bu.SLDPRT
Cabinet_cabin_1_AL12/Component/Fuse_terminal_block/3211861.SLDPRT
Cabinet_cabin_1_AL12/env/2900676.stp
Cabinet_cabin_1_AL12/env/2909575.stp
Cabinet_cabin_1_AL12/env/2966728_01.SLDPRT
Cabinet_cabin_1_AL12/env/2966728_02.SLDPRT
Cabinet_cabin_1_AL12/env/3211861.SLDPRT
Cabinet_cabin_1_AL12/env/DIN_rail.SLDPRT
Mount_camera/Mount_camera_FN/nut.SLDPRT
Mount_camera/Mount_camera_FN/serv.SLDDRW
Mount_camera/Mount_camera_OD/2200000708 Basler IP-Housing ace2 GigE Body.SLDASM
Mount_camera/Mount_camera_OD/2200000710 Basler IP-Housing Lens Tube 50mm.SLDPRT
Mount_camera/Mount_camera_OD/Mount_camera.SLDDRW
Mount_camera/Mount_camera_OD/nut.SLDPRT
Mount_camera/Mount_camera_OD/part/2200000710 Basler IP-Housing Lens Tube 50mm.SLDPRT
cabinet_cabin_1/AL_OG/2900676.stp
cabinet_cabin_1/AL_OG/2909575.stp
cabinet_cabin_1/AL_OG/2966728_01.SLDPRT
cabinet_cabin_1/AL_OG/2966728_02.SLDPRT
cabinet_cabin_1/AL_OG/3211861.SLDPRT
cabinet_cabin_1/Component/Fuse_terminal_block/3211861.SLDPRT
cabinet_cabin_1/Component/terminal_block/terminal_blue.SLDPRT
cabinet_cabin_1/cabinet/Drawing_prc/sheet.SLDDRW
cabinet_cabin_1/cabinet/Drawing_prc/sheetdetail.SLDPRT
