tuyenubuntu/aicabinet/cabinet_cabin_1/Portal_Cabin_1/Cabinet_setup_overview_v1.pdf

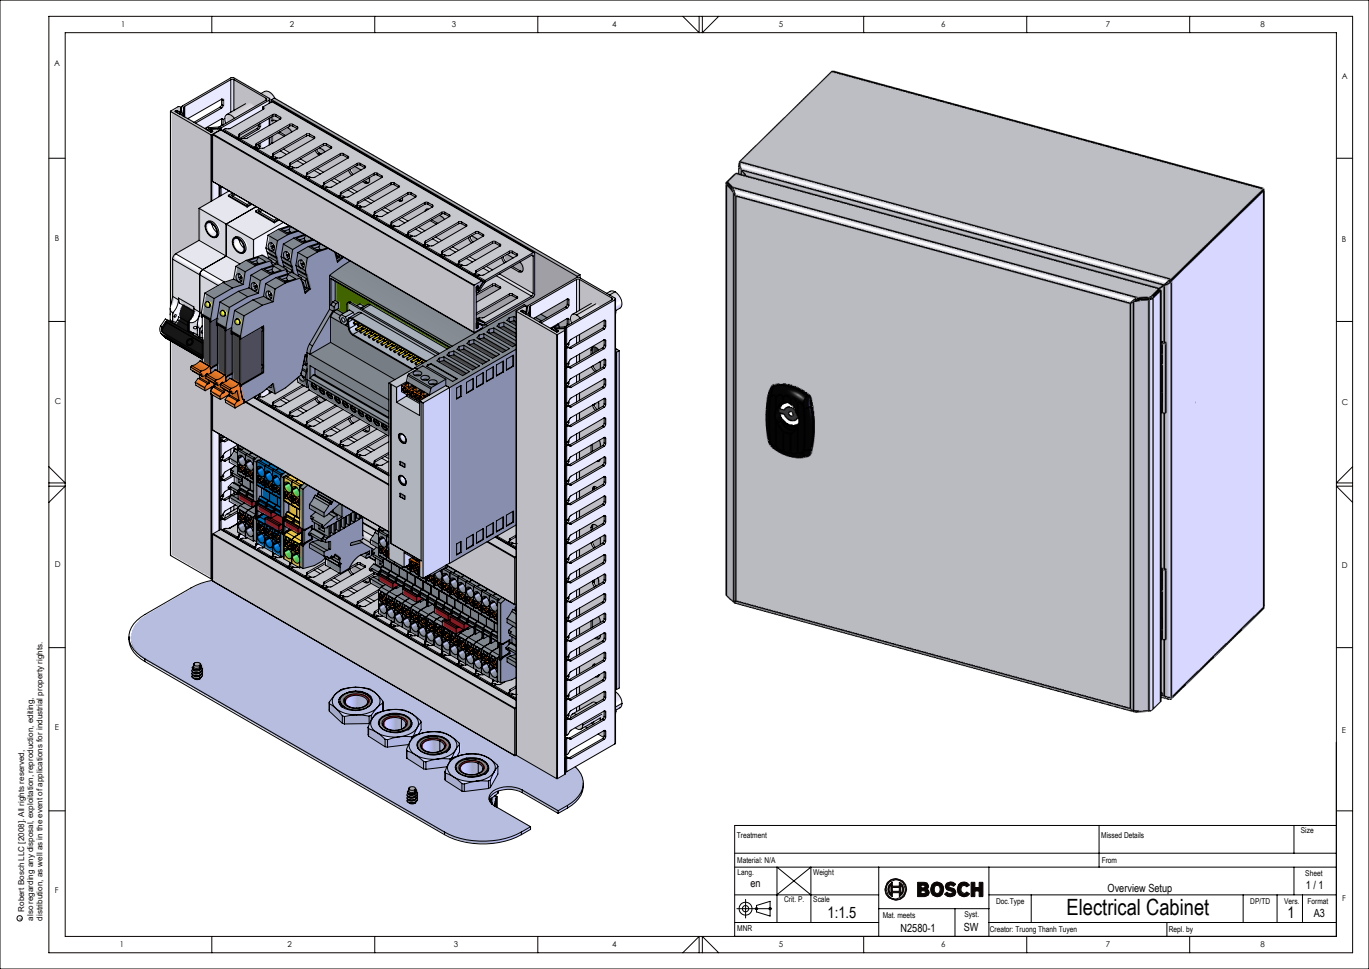
[picture p41: page 1]
Overview Setup; Missed Details; Electrical Cabinet; Vers. Format; Creator: Truong Thanh Tuyen; Repl. by; Mat. meets; Syst.; Crit. P. Scale; Material: N/A

distribution, as well as in the event of applications for industrial property rights.

also regarding any disposal, exploitation, reproduction, editing,

c Robert Bosch LLC [2008]. All rights reserved,
