tuyenubuntu/aicabinet/cabinet_cabin_1/Portal_Cabin_1/AI camera 12 Version 5.pdf

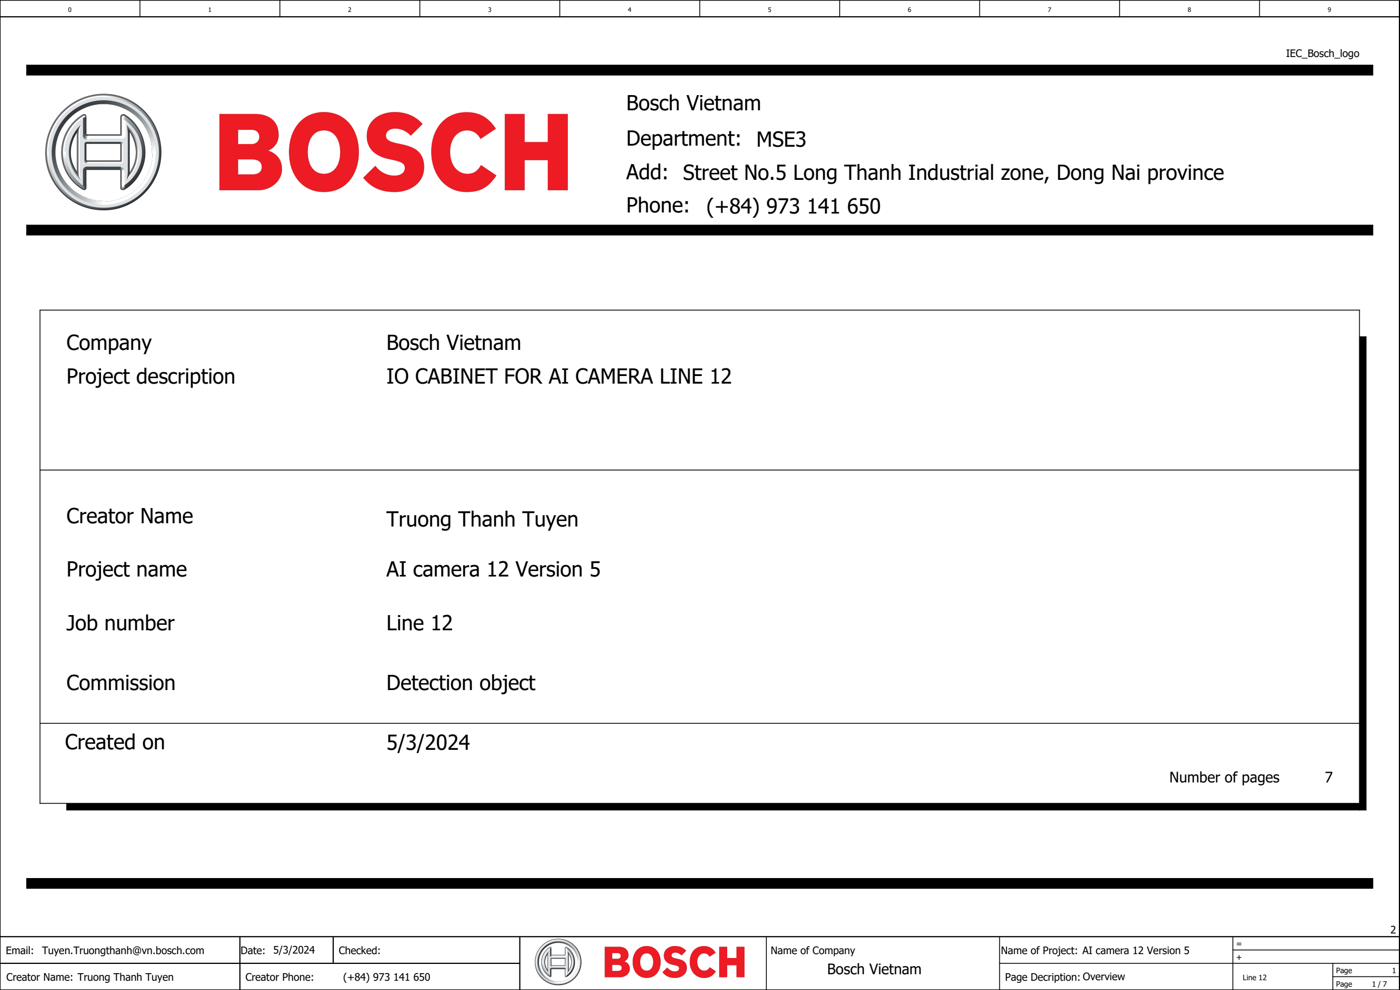
[picture p43: figure]
Page; Line 12; Creator Name:; Page Decription:; Date:; Checked:; Name of Company; Name of Project:; Truong Thanh Tuyen; Creator Phone:; AI camera 12 Version 5; Bosch Vietnam; Overview; Email: Tuyen.Truongthanh@vn.bosch.com; Number of pages; Commission; Created on; Job number; IEC_Bosch_logo; Project name; Company; Detection object; Department:; Add:; Phone:; Creator Name; MSE3

Project description | IO CABINET FOR AI CAMERA LINE 12

# Street No.5 Long Thanh Industrial zone, Dong Nai province

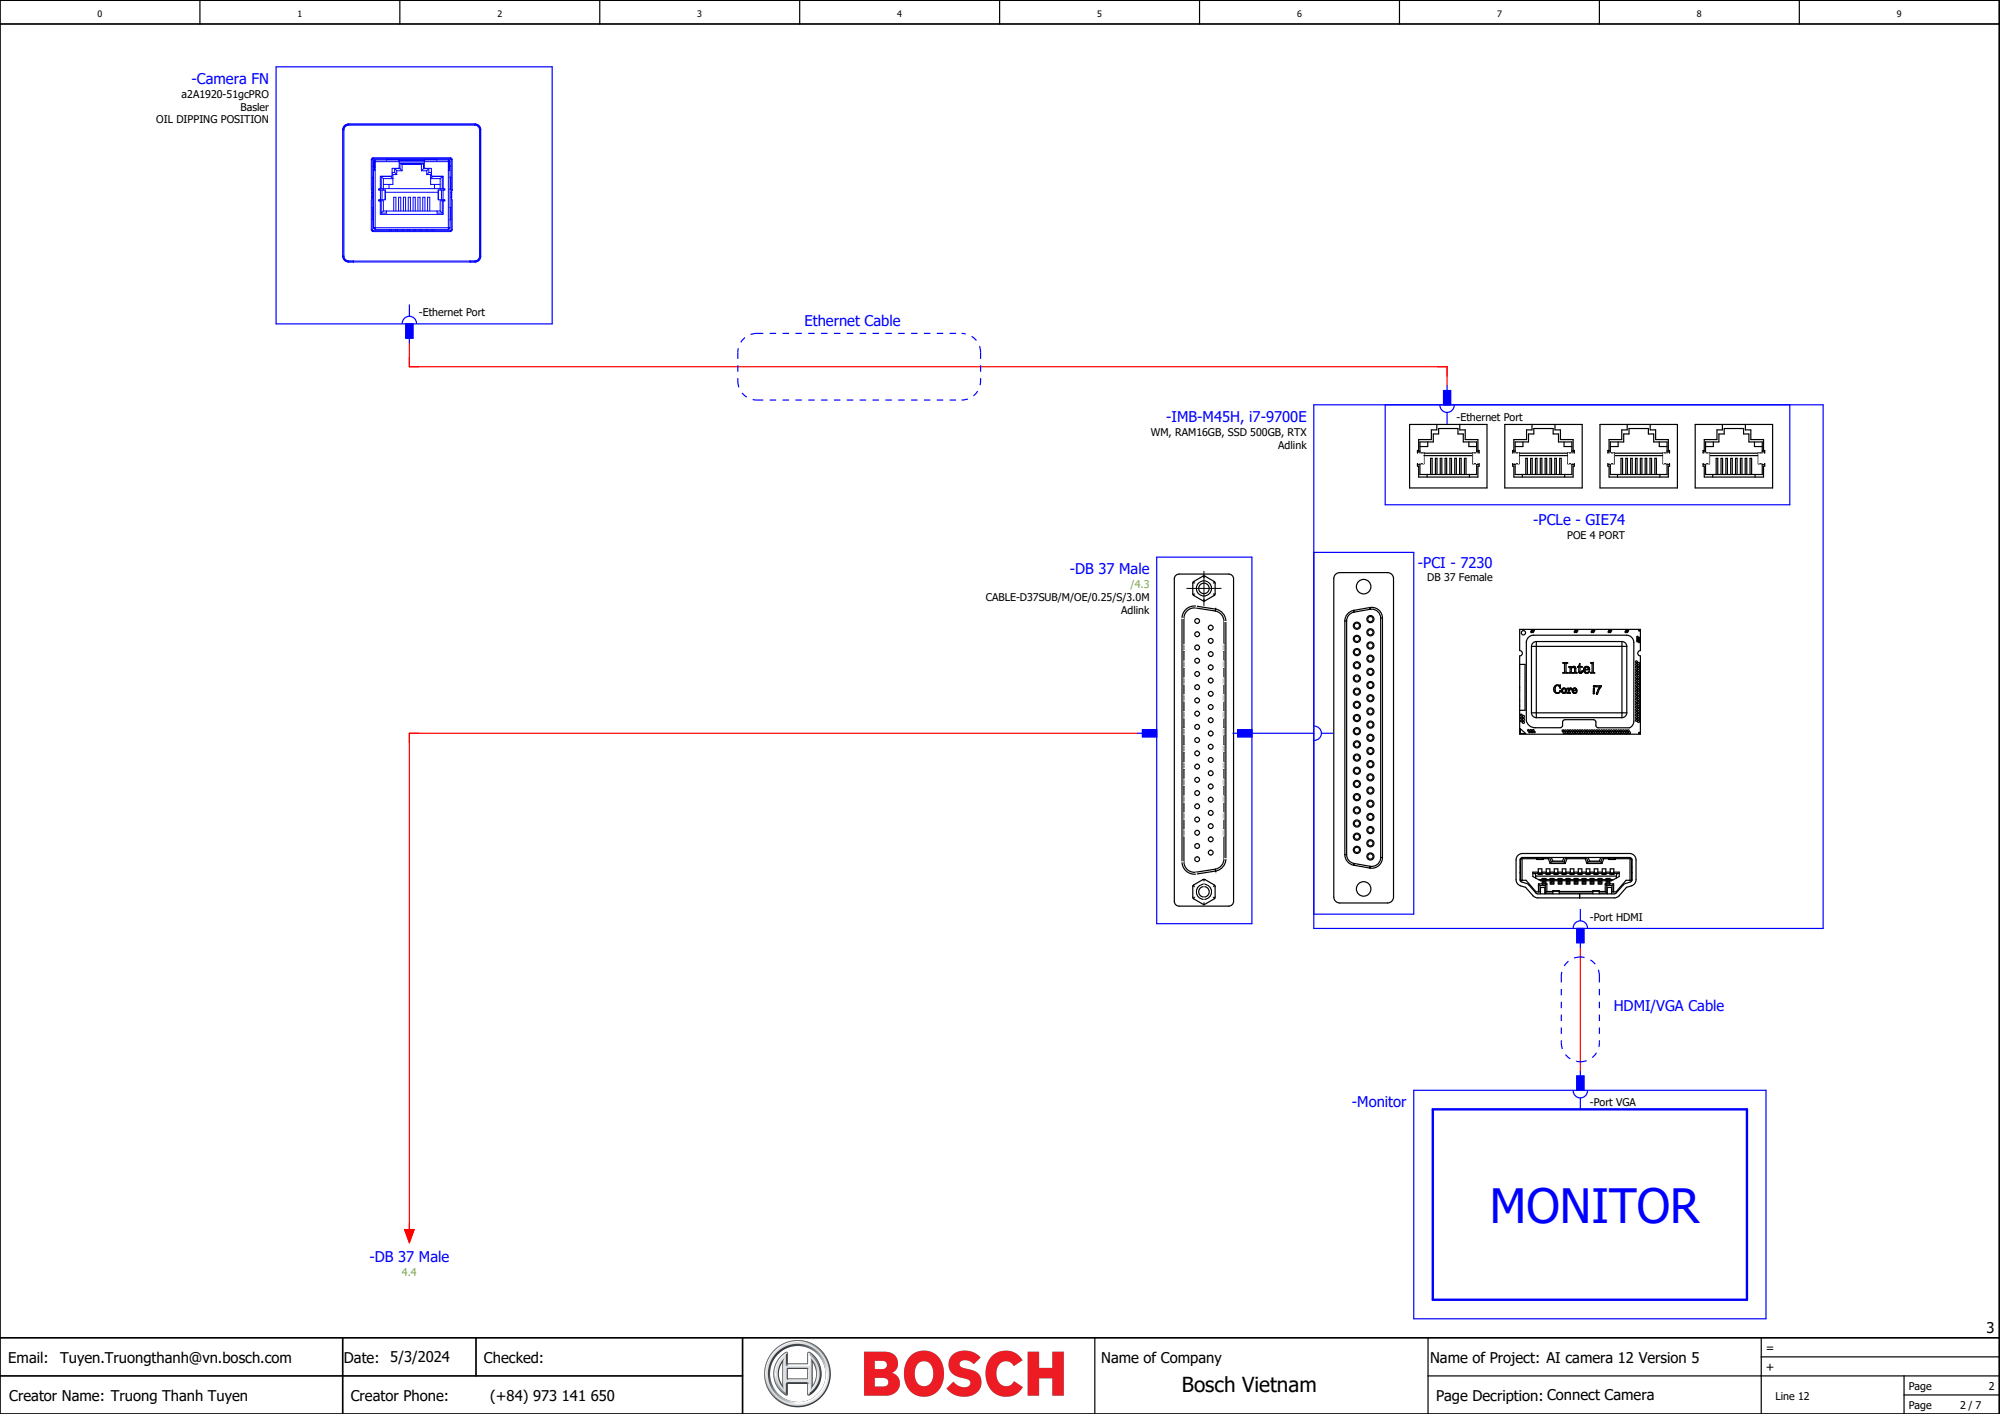
[picture p44: page 2]
Connect Camera; Adlink; -PCI - 7230; DB 37 Female; -PCLe - GIE74; POE 4 PORT; -Camera FN; a2A1920-51gcPRO Basler; Ethernet Cable; MONITOR; -Monitor; -Port VGA; -DB 37 Male; /4.3 CABLE-D37SUB/M/OE/0.25/S/3.0M Adlink; -Port HDMI; -Ethernet Port

OIL DIPPING POSITION

-IMB-M45H, i7-9700E
WM, RAM16GB, SSD 500GB, RTX

HDMI/VGA Cable

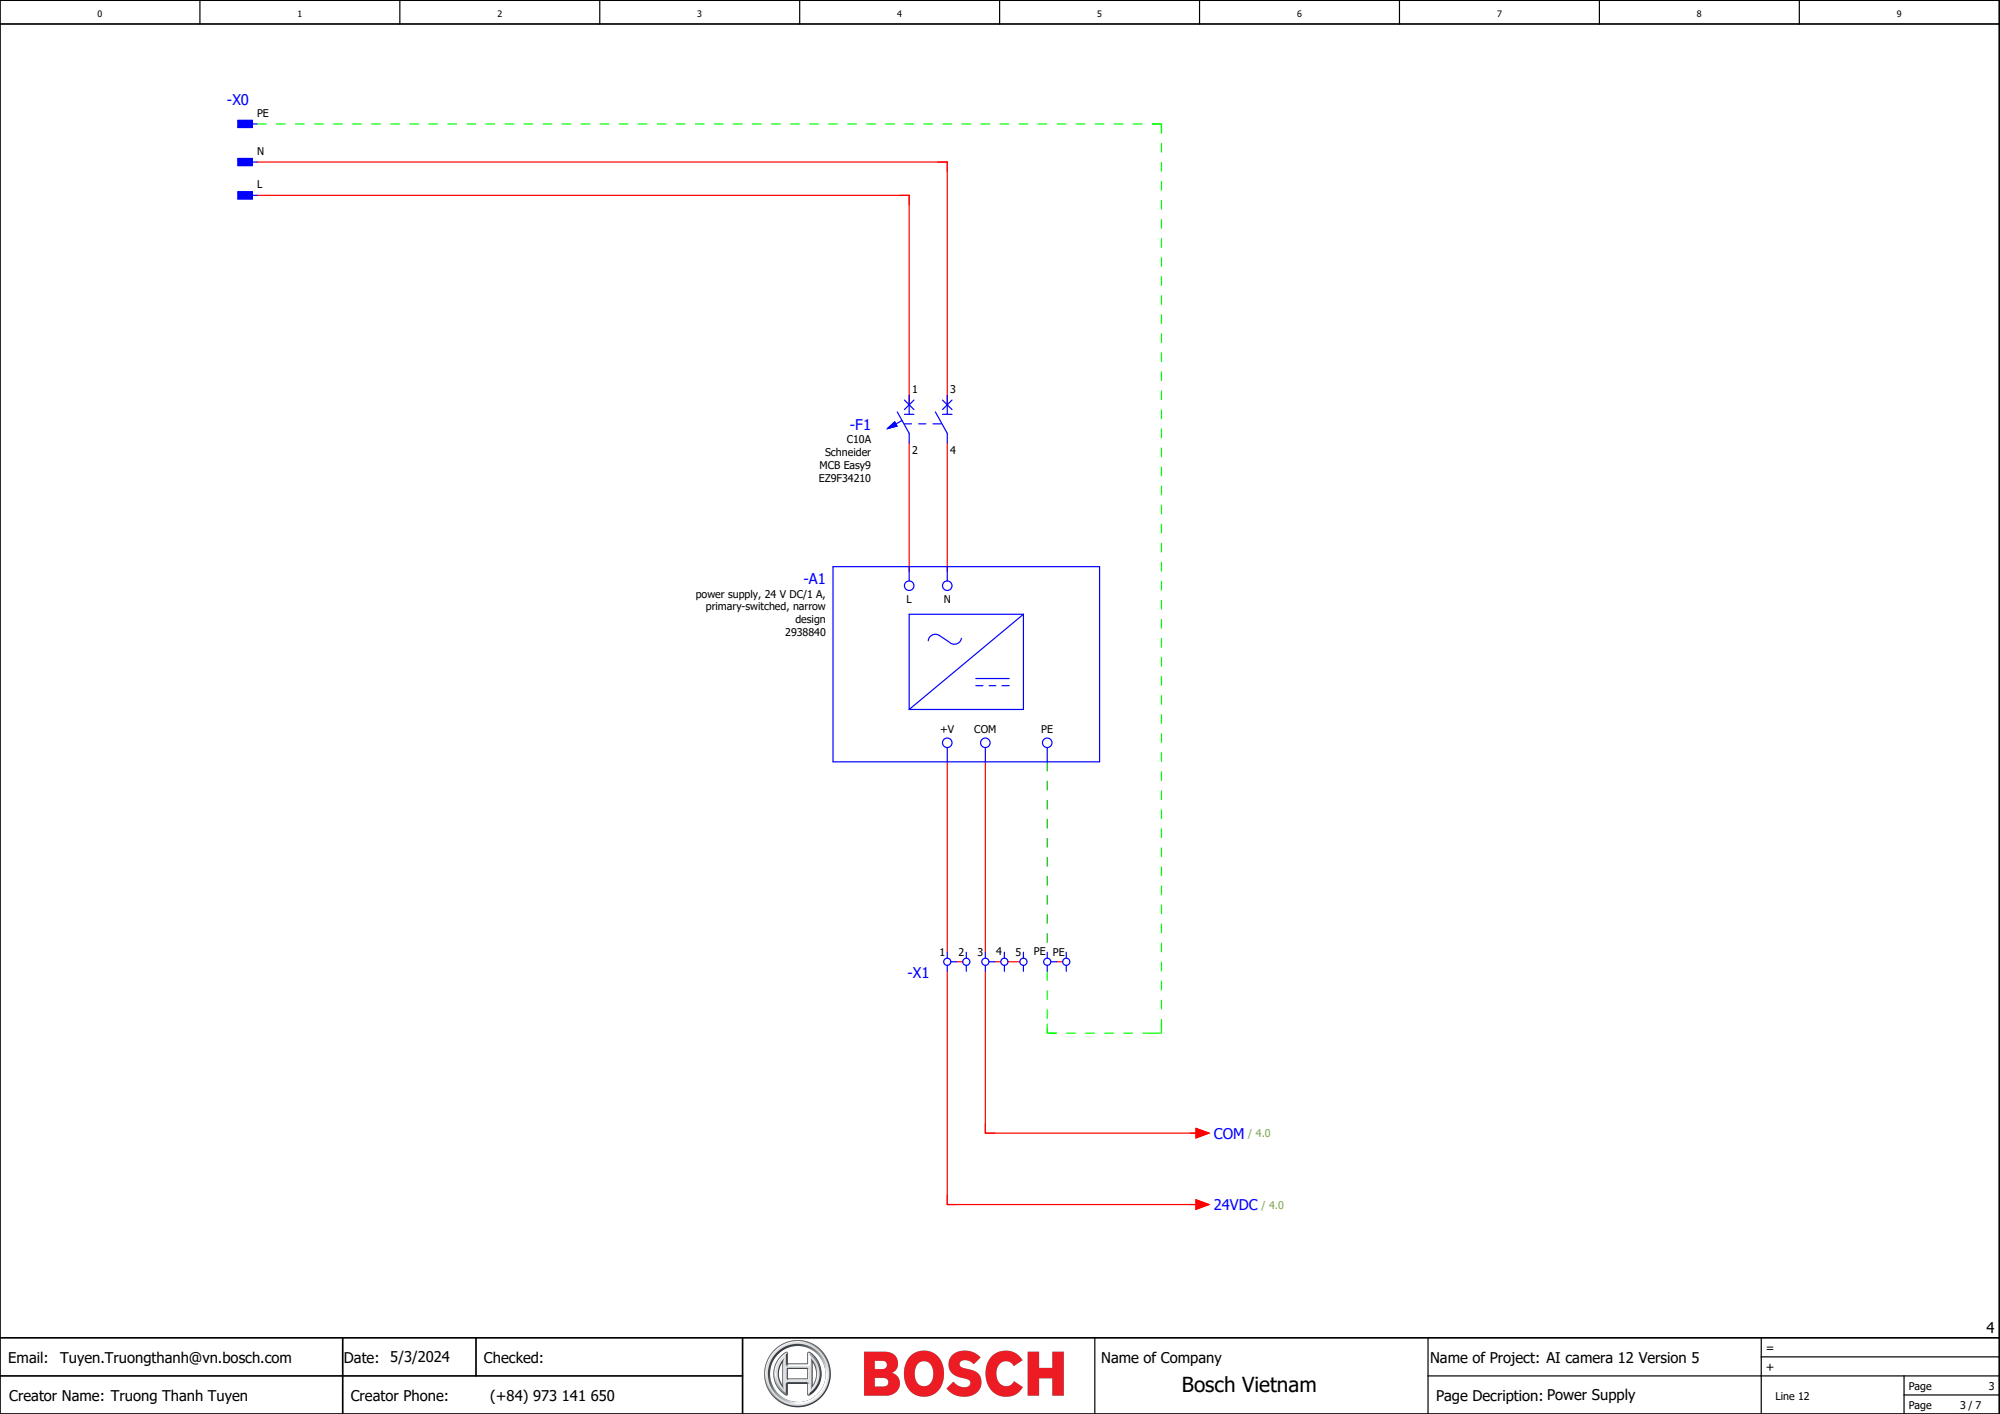
[picture p45: page 3]
Power Supply; C10A Schneider MCB Easy9 EZ9F34210; design 2938840; COM; COM / 4.0; 24VDC / 4.0

power supply, 24 V DC/1 A,
primary-switched, narrow

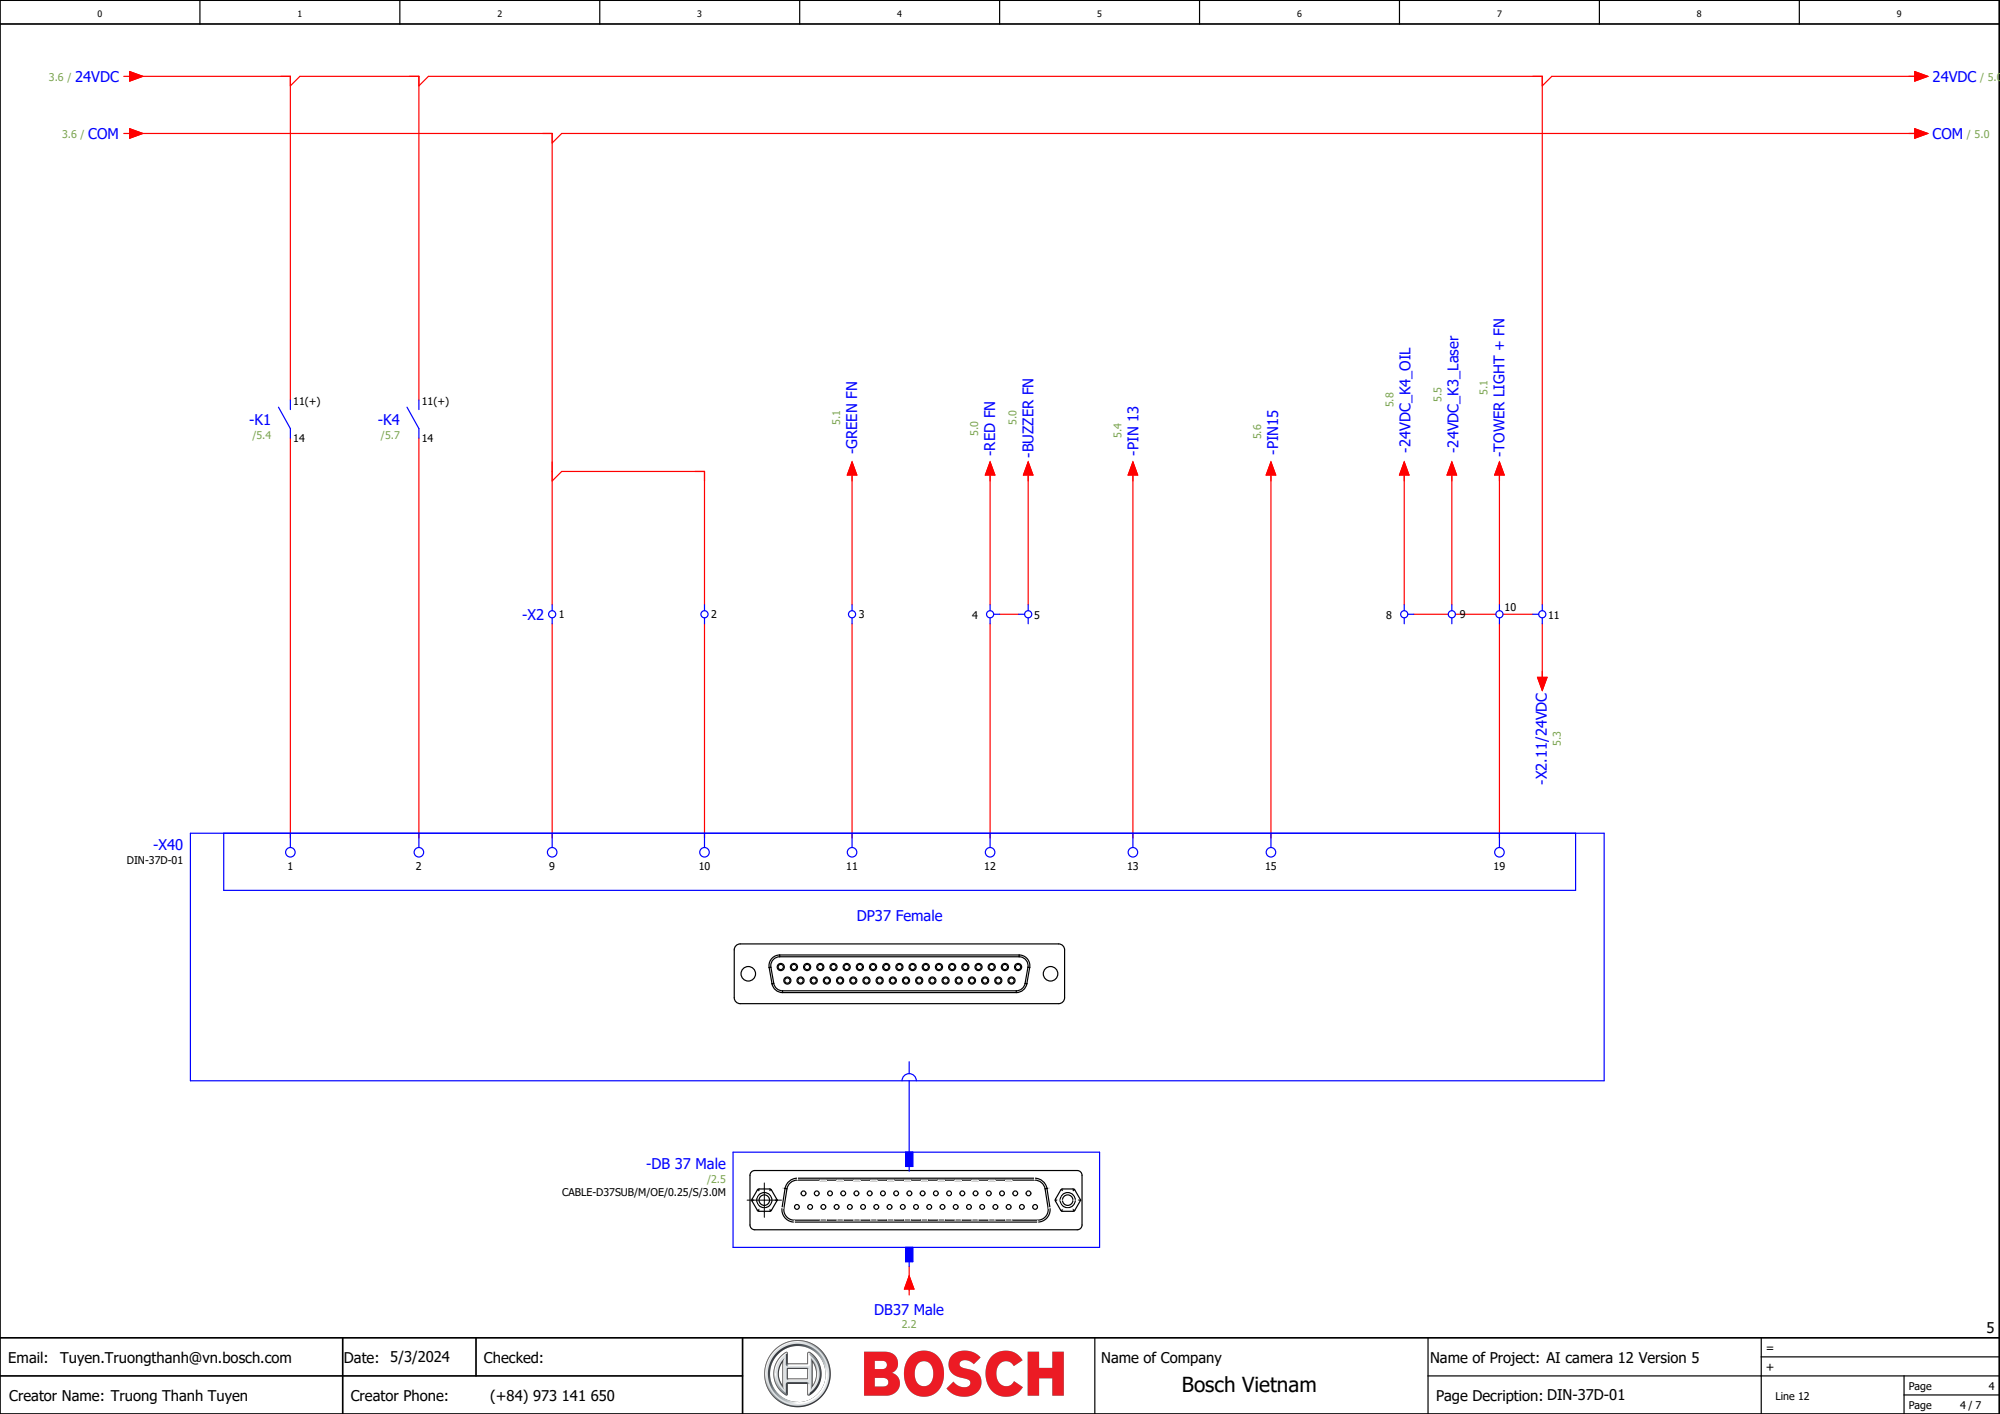
[picture p46: page 4]
DIN-37D-01; DP37 Female; -DB 37 Male; /2.5 CABLE-D37SUB/M/OE/0.25/S/3.0M; DB37 Male; 3.6 / 24VDC; 3.6 / COM; -PIN15; 24VDC / 5.0; COM / 5.0; -X2.11/24VDC; -GREEN FN; -RED FN; -BUZZER FN; -PIN 13; -24VDC_K3_Laser; -24VDC_K4_OIL

-TOWER LIGHT + FN

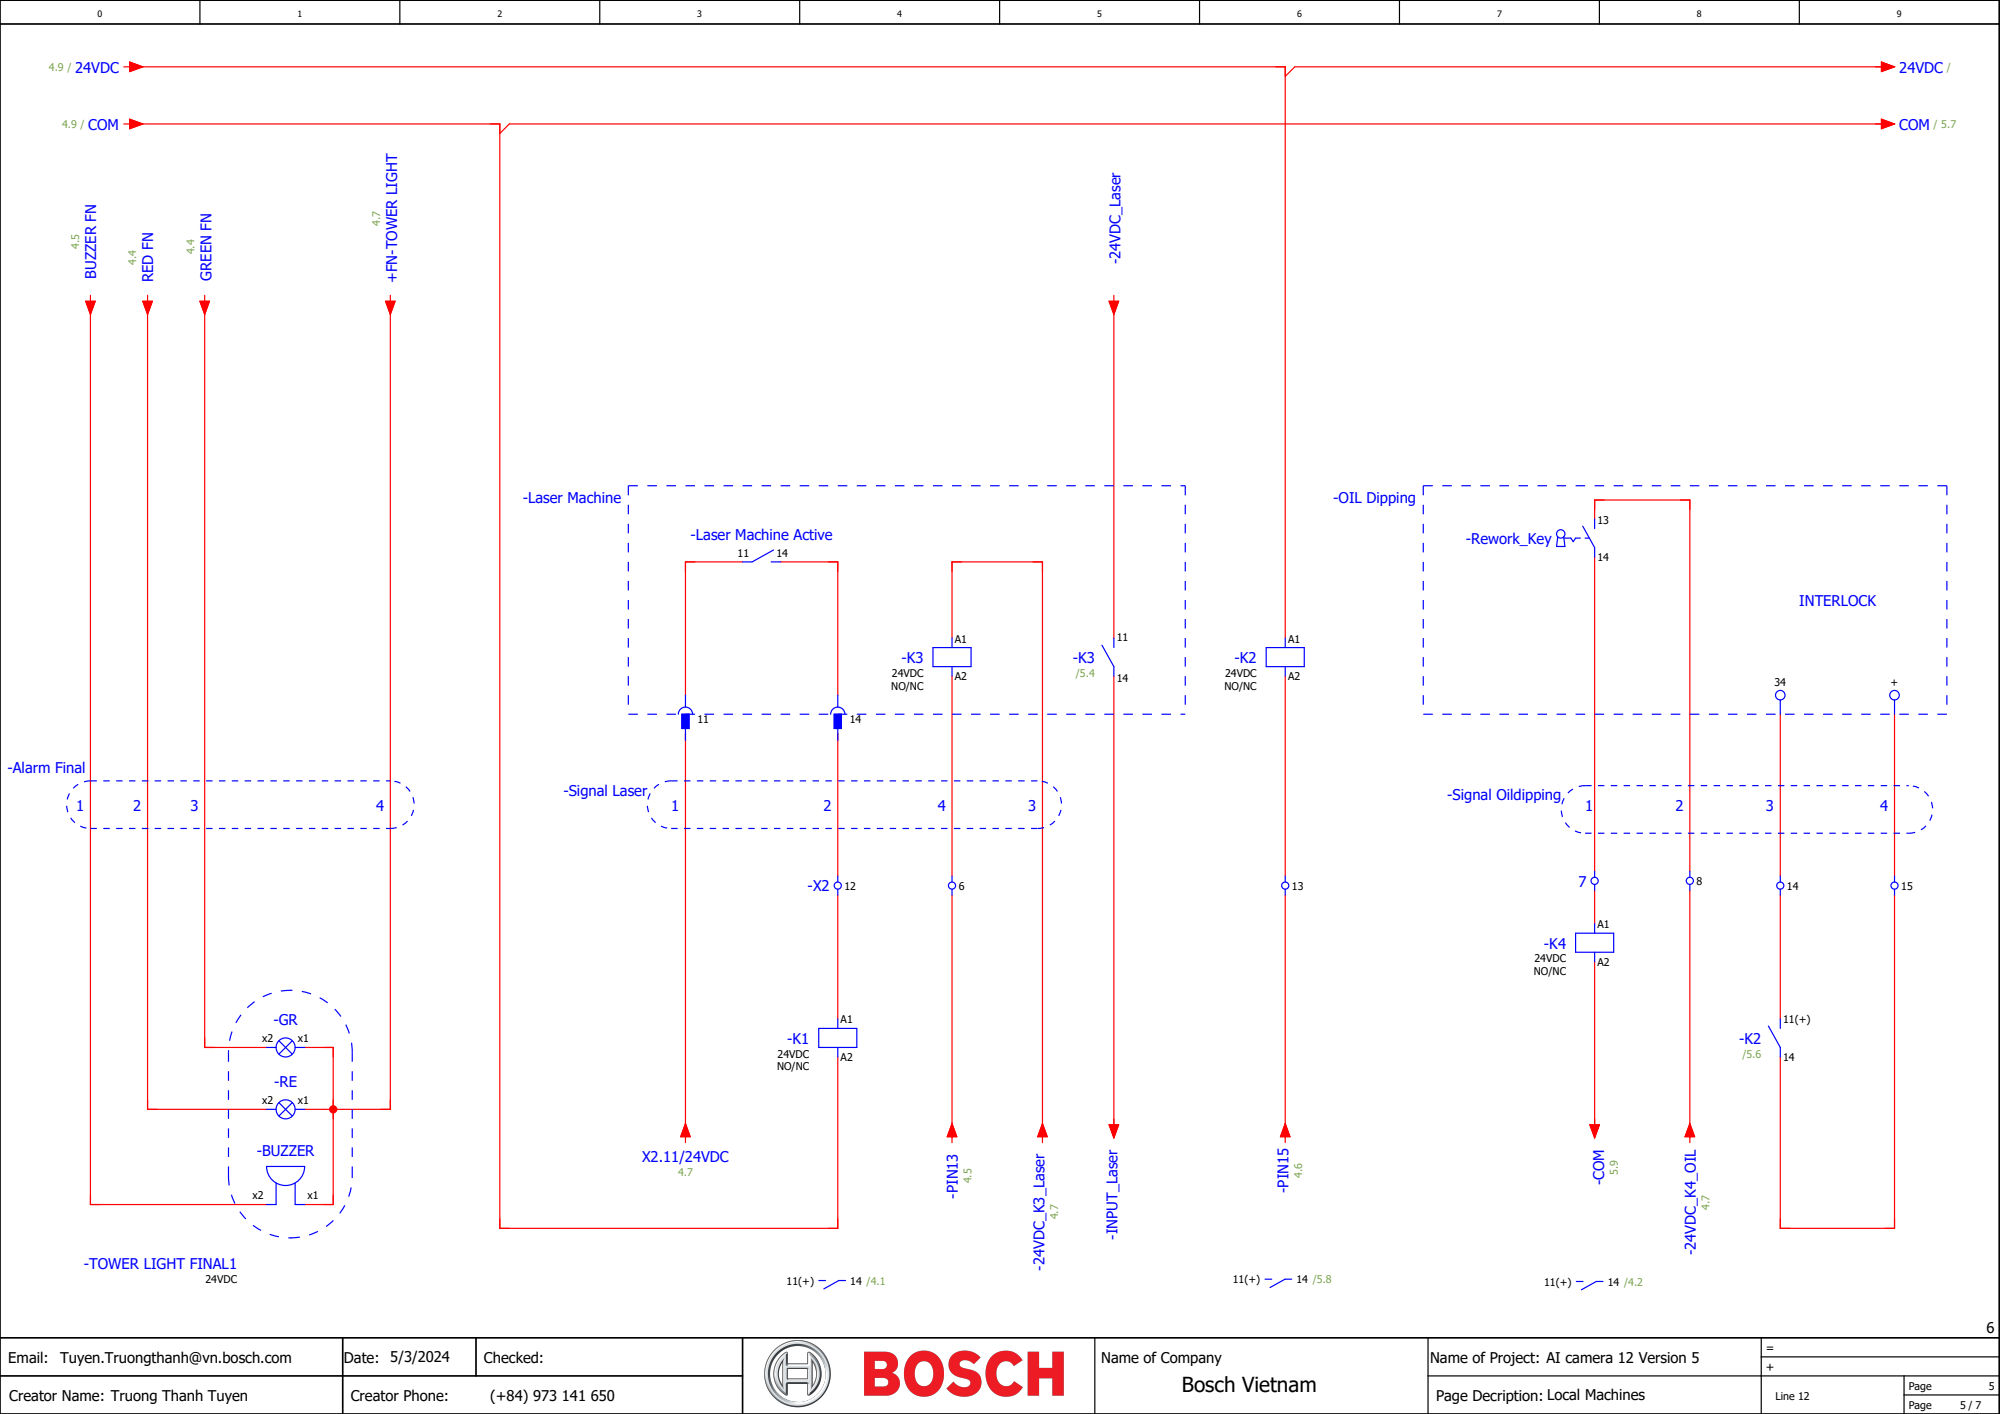
[picture p47: page 5]
Local Machines; INTERLOCK; -BUZZER; -Laser Machine; 24VDC NO/NC; -OIL Dipping; -Rework_Key; -Signal Laser; -Signal Oildipping; -Alarm Final; -TOWER LIGHT FINAL1; 24VDC; 4.9 / 24VDC; 4.9 / COM; 24VDC /; COM / 5.7; X2.11/24VDC; -PIN15; GREEN FN; RED FN; BUZZER FN; -24VDC_K4_OIL; -COM; -24VDC_K3_Laser; -PIN13; -INPUT_Laser -24VDC_Laser

+FN-TOWER LIGHT

-Laser Machine Active

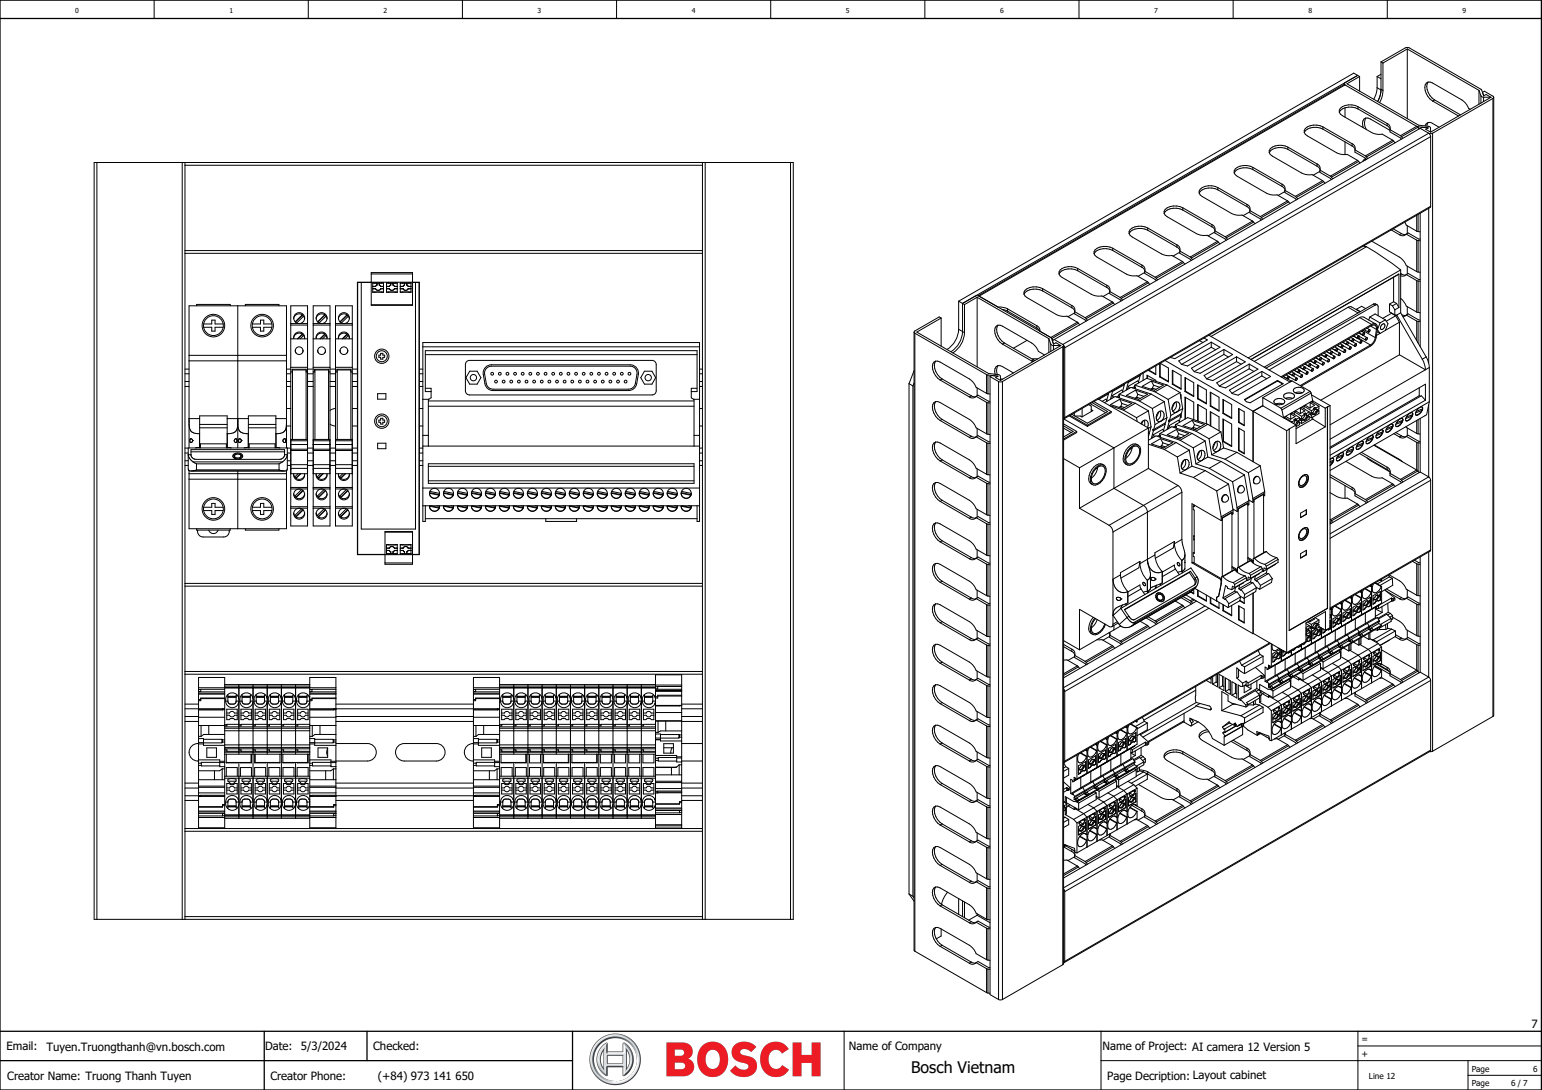
[picture p48: page 6]
Layout cabinet

# Part List AL12

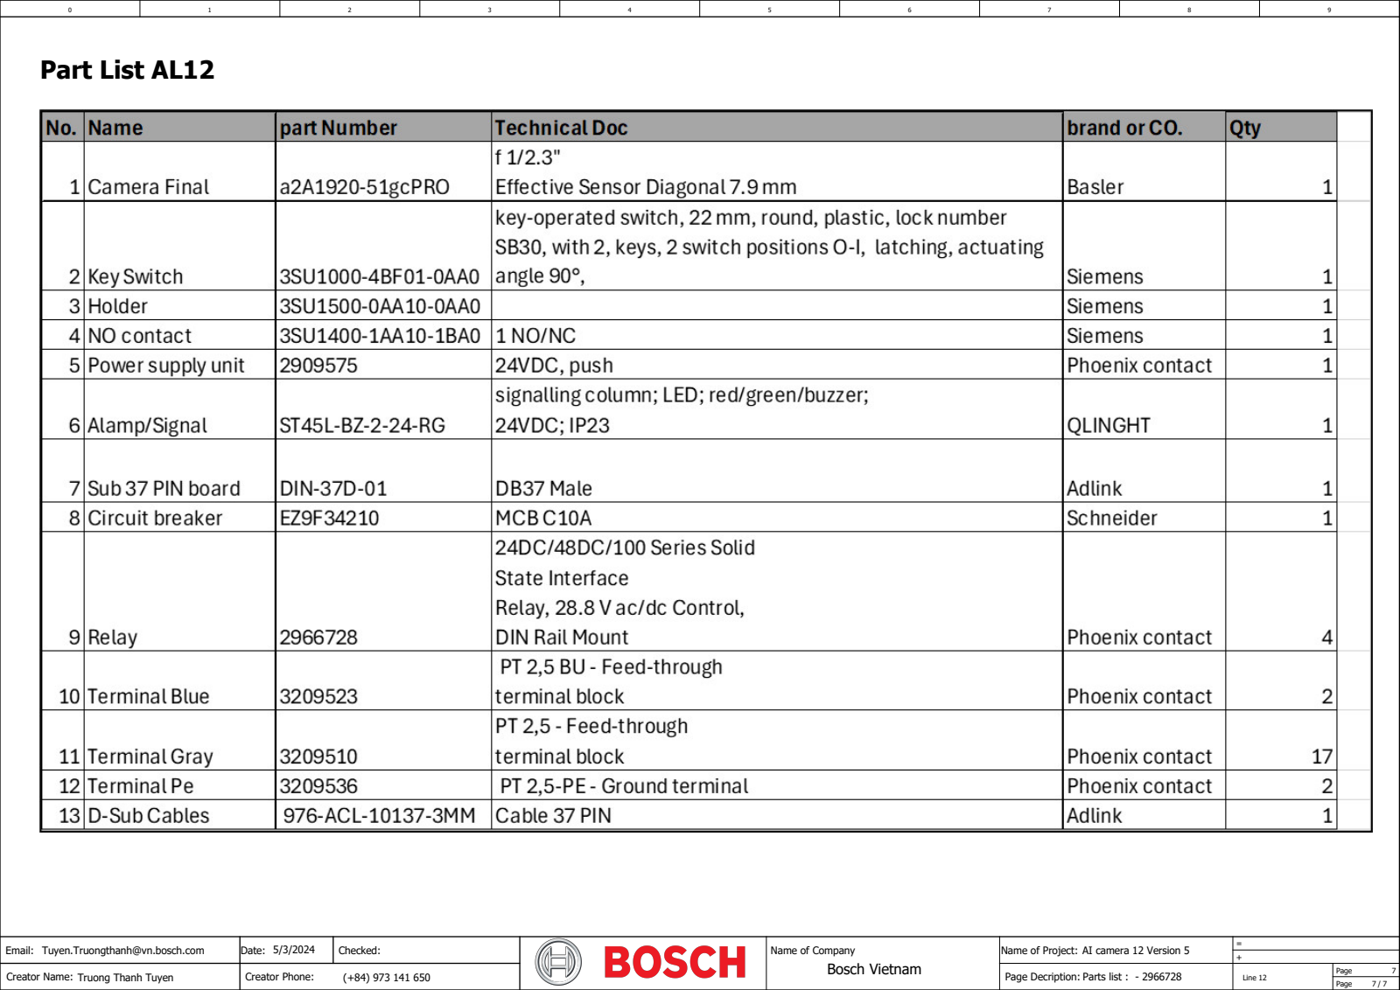
[picture p49: page 7]

Parts list : - 2966728
