tuyenubuntu/aicabinet/cabinet_cabin_1/Portal_Cabin_1/cabinet_technical_drawing_v1.pdf

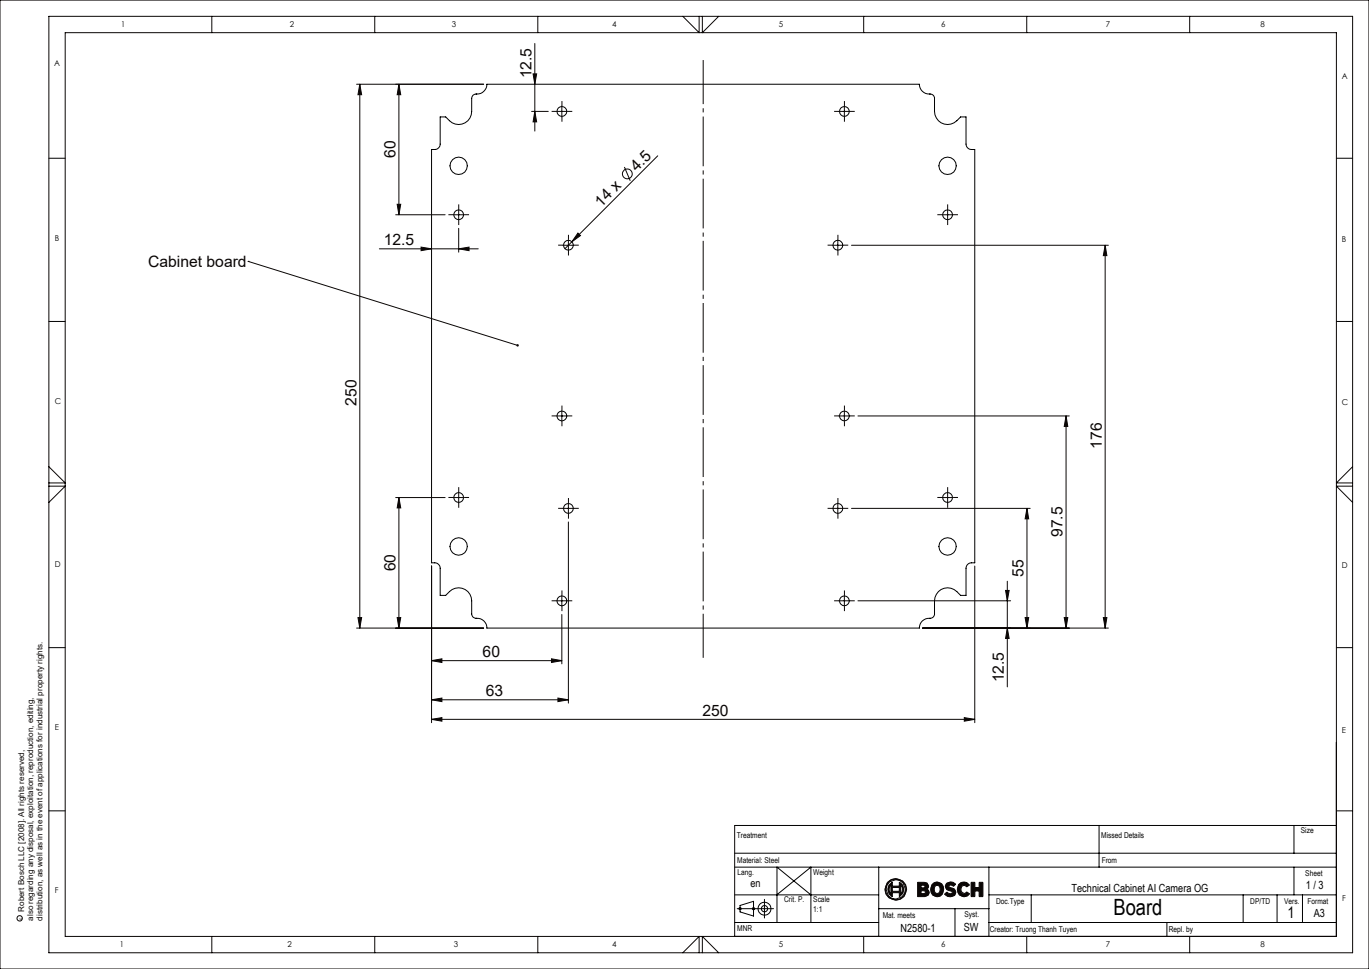
[picture p50: page 1]
Cabinet board; Missed Details; Vers. Format; Creator: Truong Thanh Tuyen; Repl. by; Mat. meets; Syst.; Crit. P.; Material: Steel

distribution, as well as in the event of applications for industrial property rights.

also regarding any disposal, exploitation, reproduction, editing,

c Robert Bosch LLC [2008]. All rights reserved,

From
Technical Cabinet AI Camera OG
Board

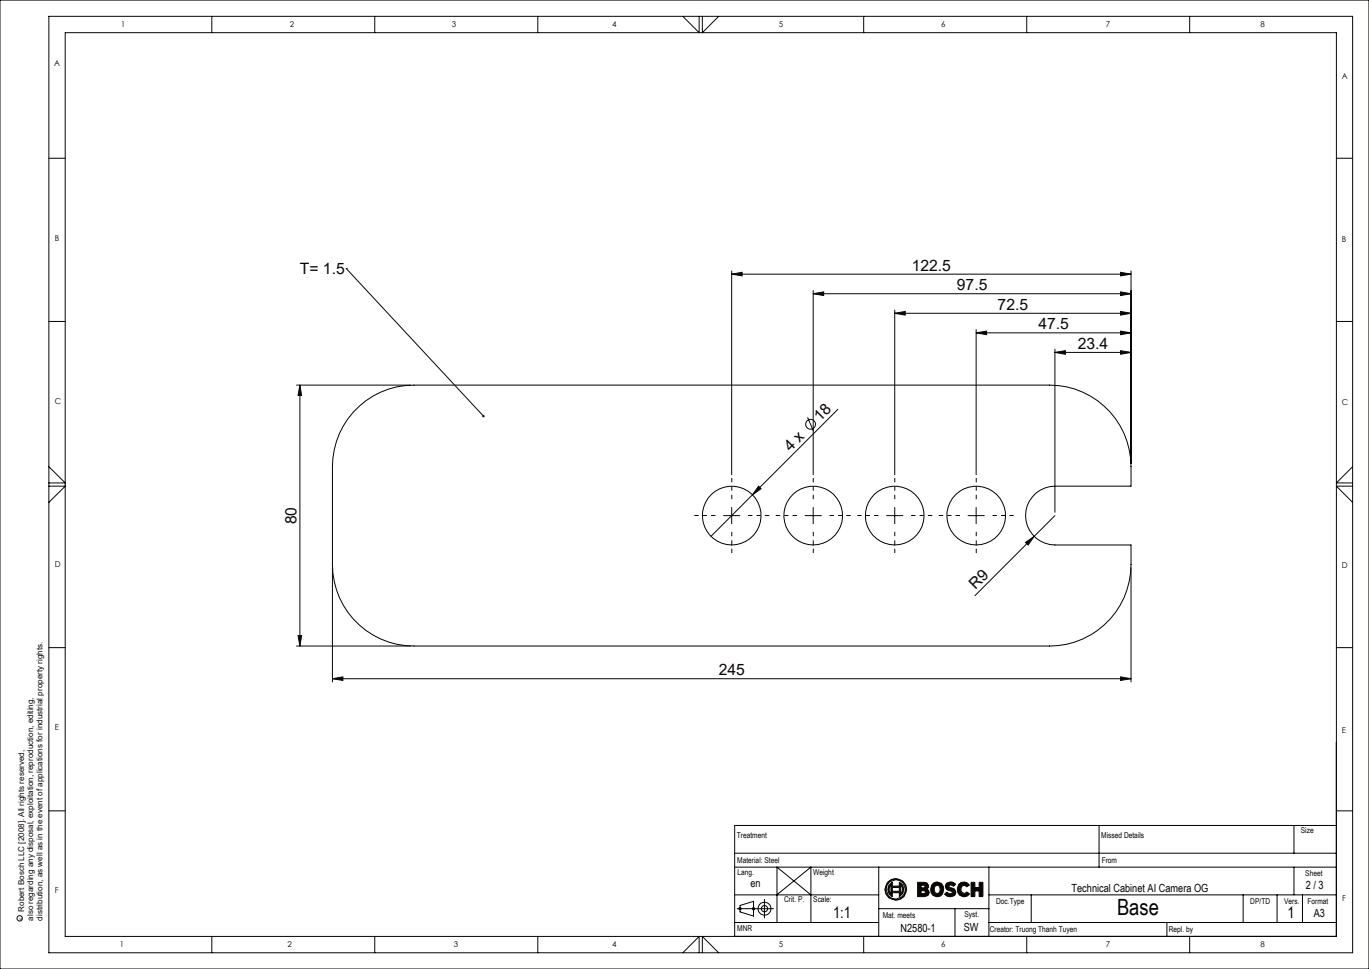
[picture p51: page 2]
Missed Details; Mat. meets; Syst.; Crit. P. Scale:; Material: Steel

distribution, as well as in the event of applications for industrial property rights.

also regarding any disposal, exploitation, reproduction, editing,

c Robert Bosch LLC [2008]. All rights reserved,

From
Technical Cabinet AI Camera OG
Base

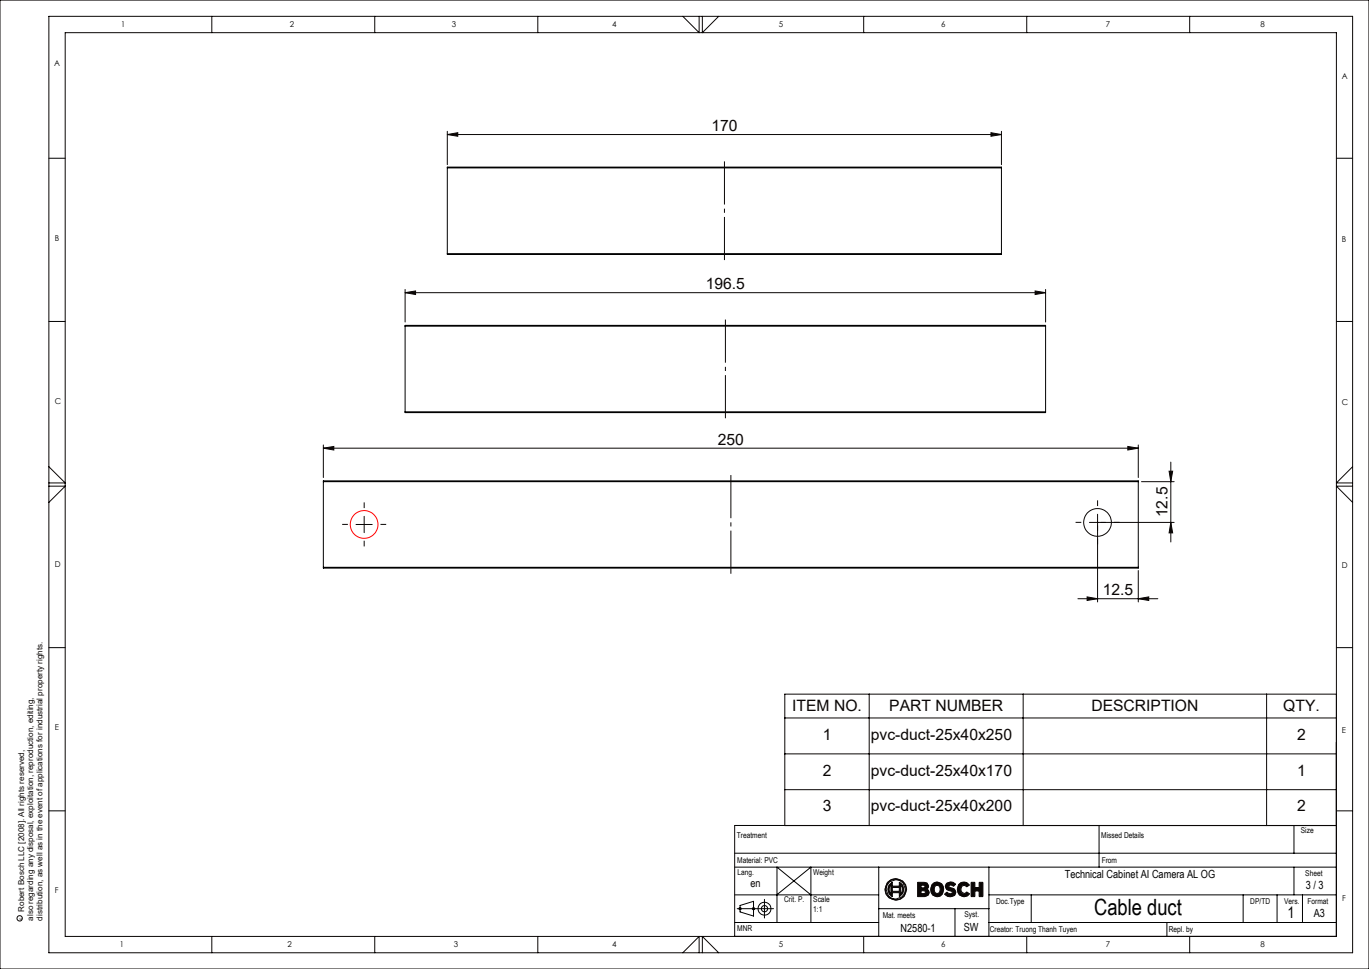
[picture p52: page 3]
Missed Details; Cable duct; Mat. meets; Syst.; Crit. P.; Material: PVC

distribution, as well as in the event of applications for industrial property rights.

ITEM NO. | PART NUMBER | DESCRIPTION | QTY.
1 | pvc-duct-25x40x250 | | 2
2 | pvc-duct-25x40x170 | | 1
3 | pvc-duct-25x40x200 | | 2

also regarding any disposal, exploitation, reproduction, editing,

c Robert Bosch LLC [2008]. All rights reserved,

From
Technical Cabinet AI Camera AL OG
