tuyenubuntu/aicabinet/cabinet_cabin_1/Portal_Cabin_1/frame cabinet line 12.pdf

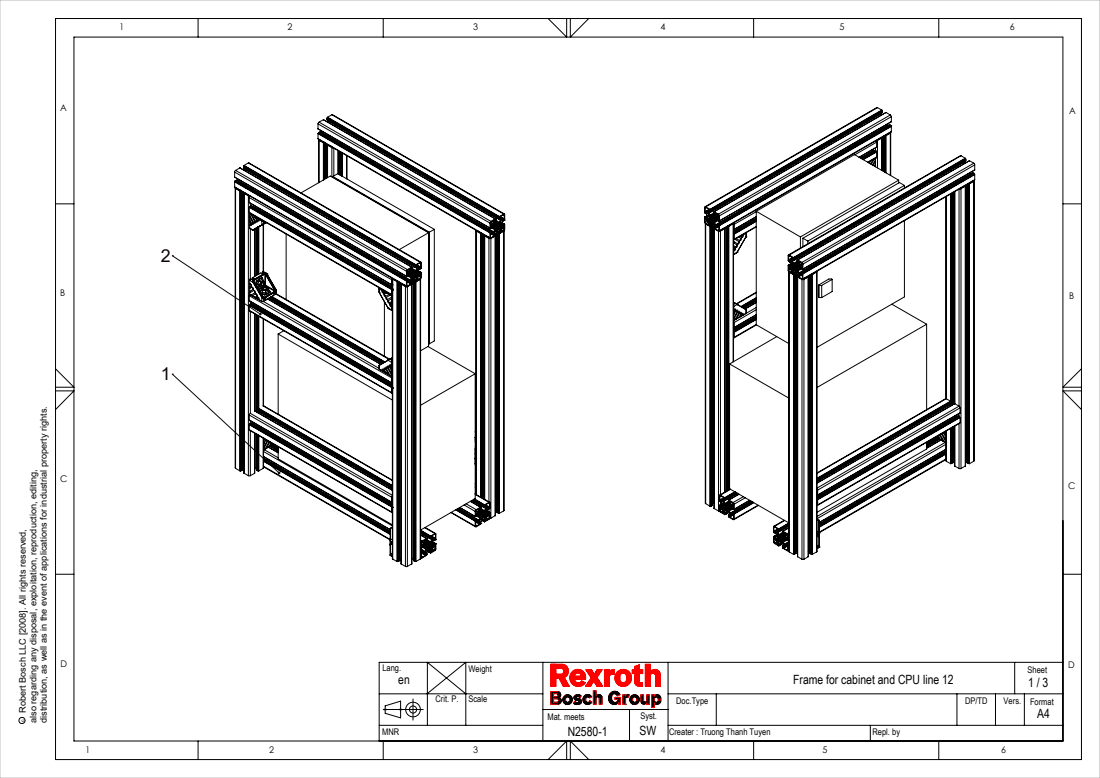
[picture p53: page 1]
Vers. Format; Creater : Truong Thanh Tuyen; Repl. by; Mat. meets; Syst.; Crit. P. Scale; Frame for cabinet and CPU line 12

distribution, as well as in the event of applications for industrial property rights.

also regarding any disposal, exploitation, reproduction, editing,

c Robert Bosch LLC [2008]. All rights reserved,

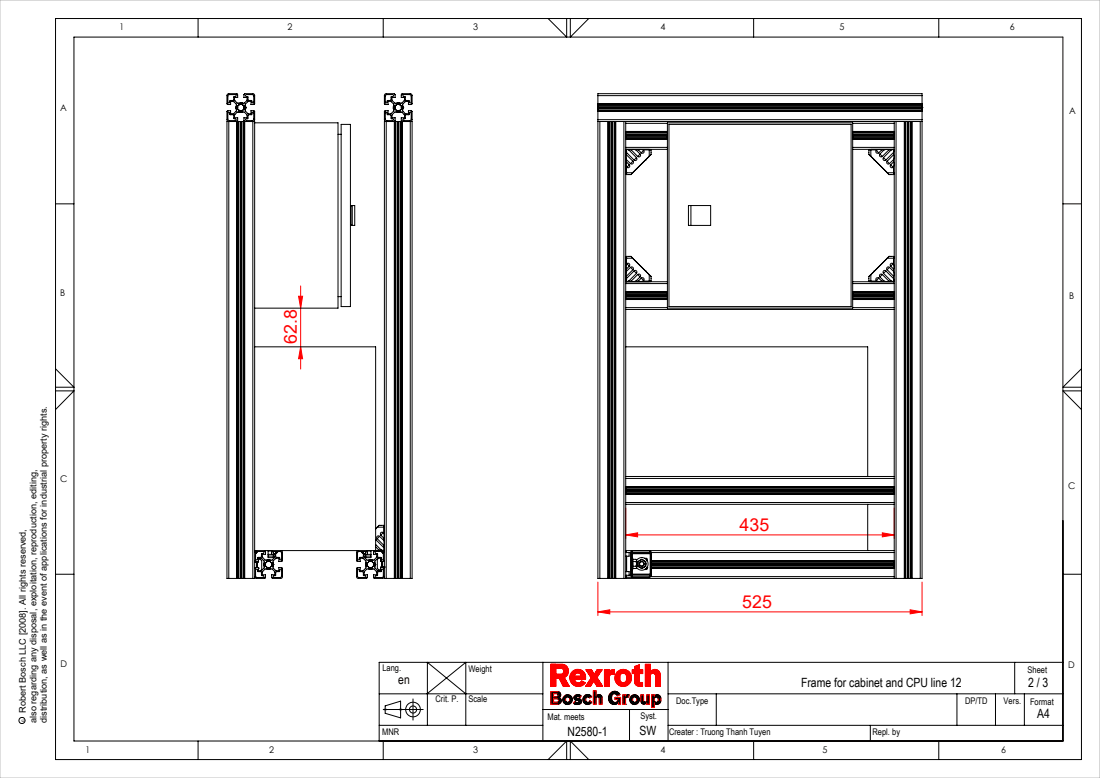
[picture p54: page 2]
Vers. Format; Crit. P. Scale; Frame for cabinet and CPU line 12

distribution, as well as in the event of applications for industrial property rights.

also regarding any disposal, exploitation, reproduction, editing,

c Robert Bosch LLC [2008]. All rights reserved,

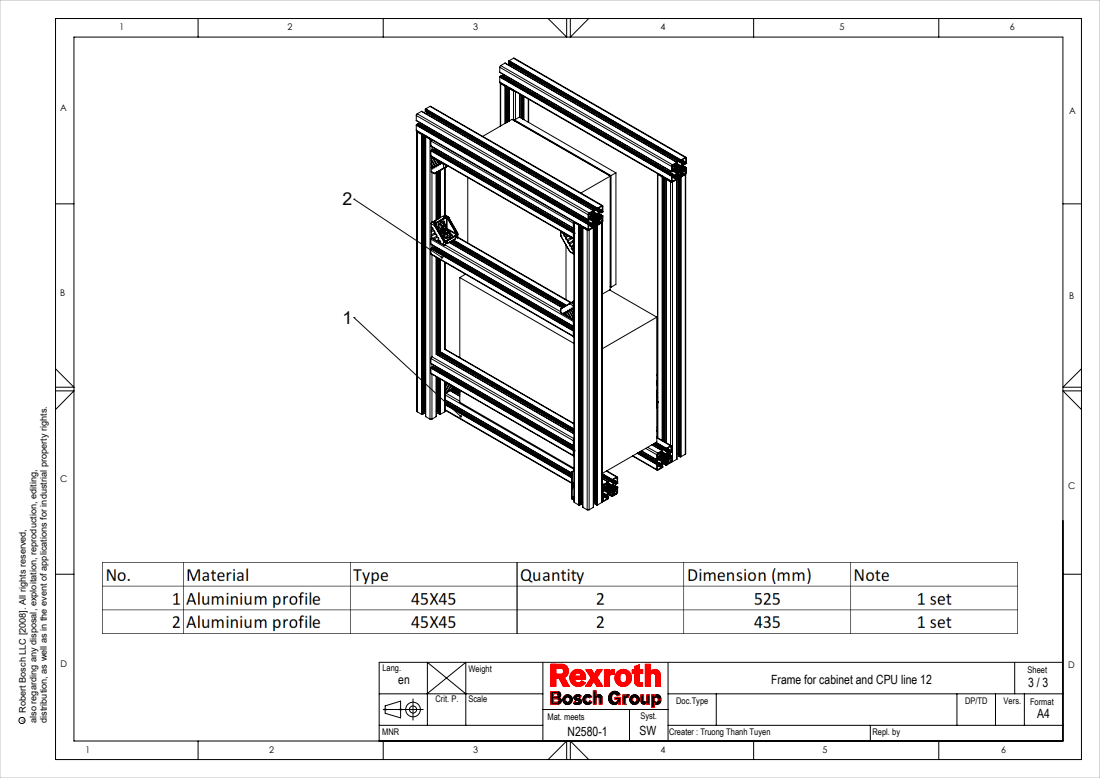
[picture p55: page 3]
Vers. Format; Crit. P. Scale; Frame for cabinet and CPU line 12

distribution, as well as in the event of applications for industrial property rights.

also regarding any disposal, exploitation, reproduction, editing,

c Robert Bosch LLC [2008]. All rights reserved,
