tuyenubuntu/aicabinet/cabinet_cabin_1/Portal_Cabin_1/Mount_AI_camera_FN_V1.pdf

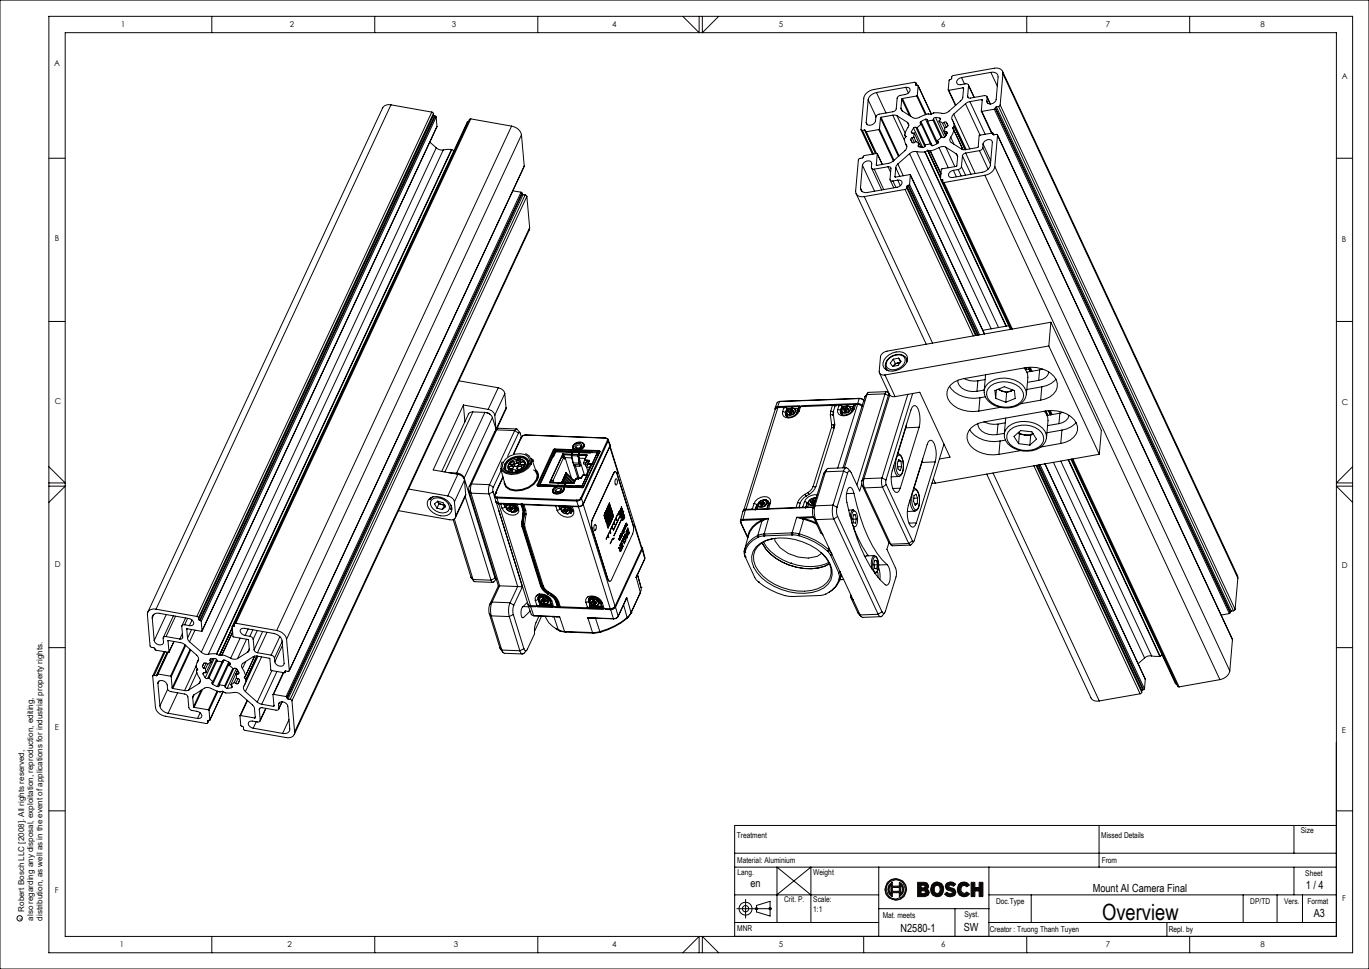
[picture p56: page 1]
Missed Details; Vers. Format; Creator : Truong Thanh Tuyen; Repl. by; Mat. meets; Syst.; Crit. P.; Material: Aluminium

distribution, as well as in the event of applications for industrial property rights.

also regarding any disposal, exploitation, reproduction, editing,

c Robert Bosch LLC [2008]. All rights reserved,

From
Mount AI Camera Final

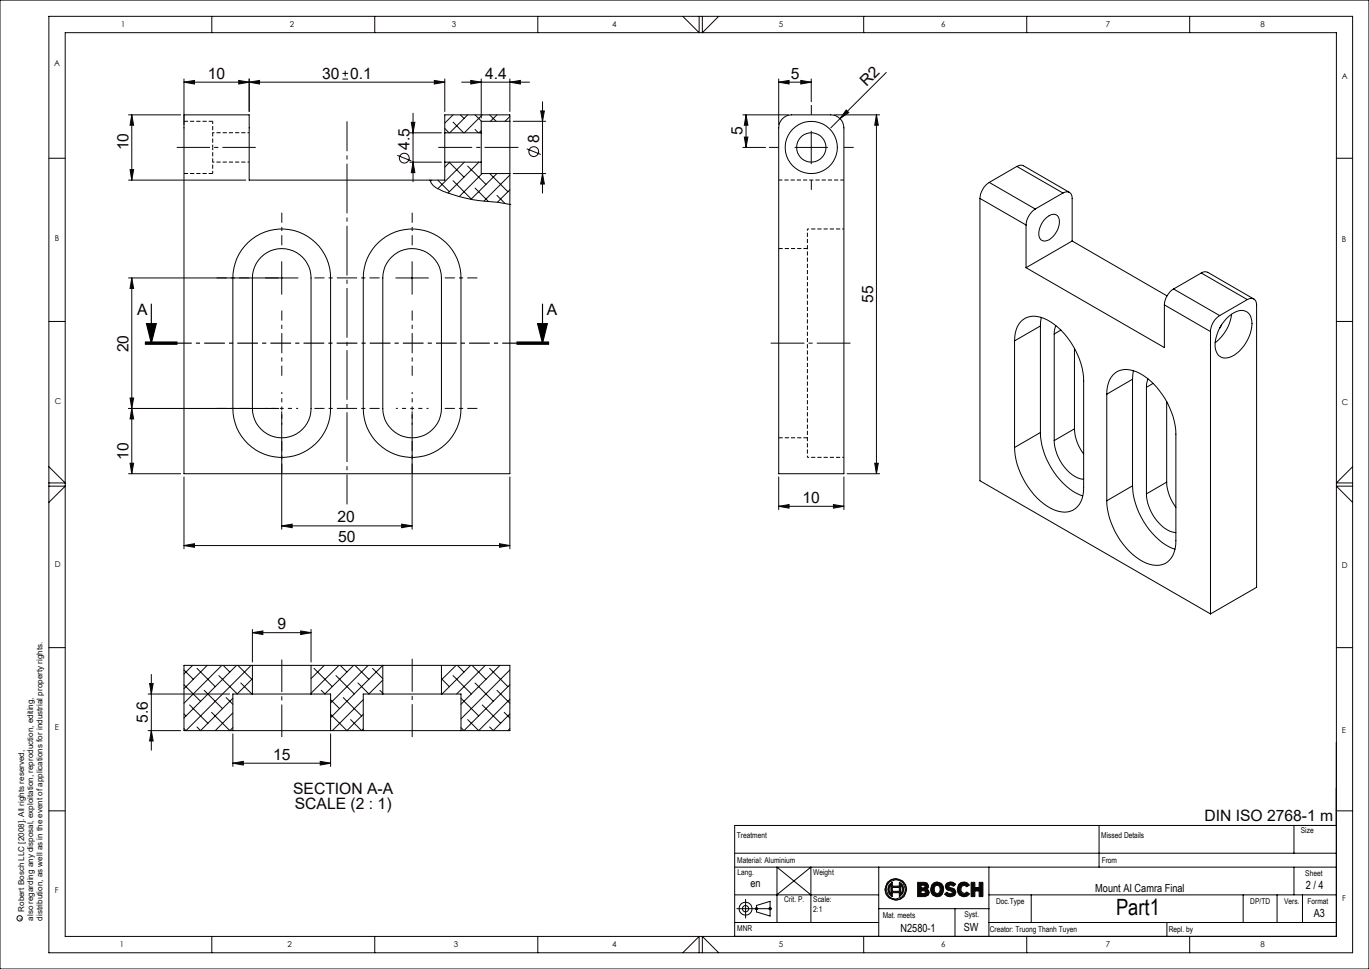
[picture p57: page 2]
SECTION A-A SCALE (2 : 1); DIN ISO 2768-1 m; Missed Details; Creator: Truong Thanh Tuyen; Repl. by; Material: Aluminium

distribution, as well as in the event of applications for industrial property rights.

also regarding any disposal, exploitation, reproduction, editing,

c Robert Bosch LLC [2008]. All rights reserved,

From
Mount AI Camra Final

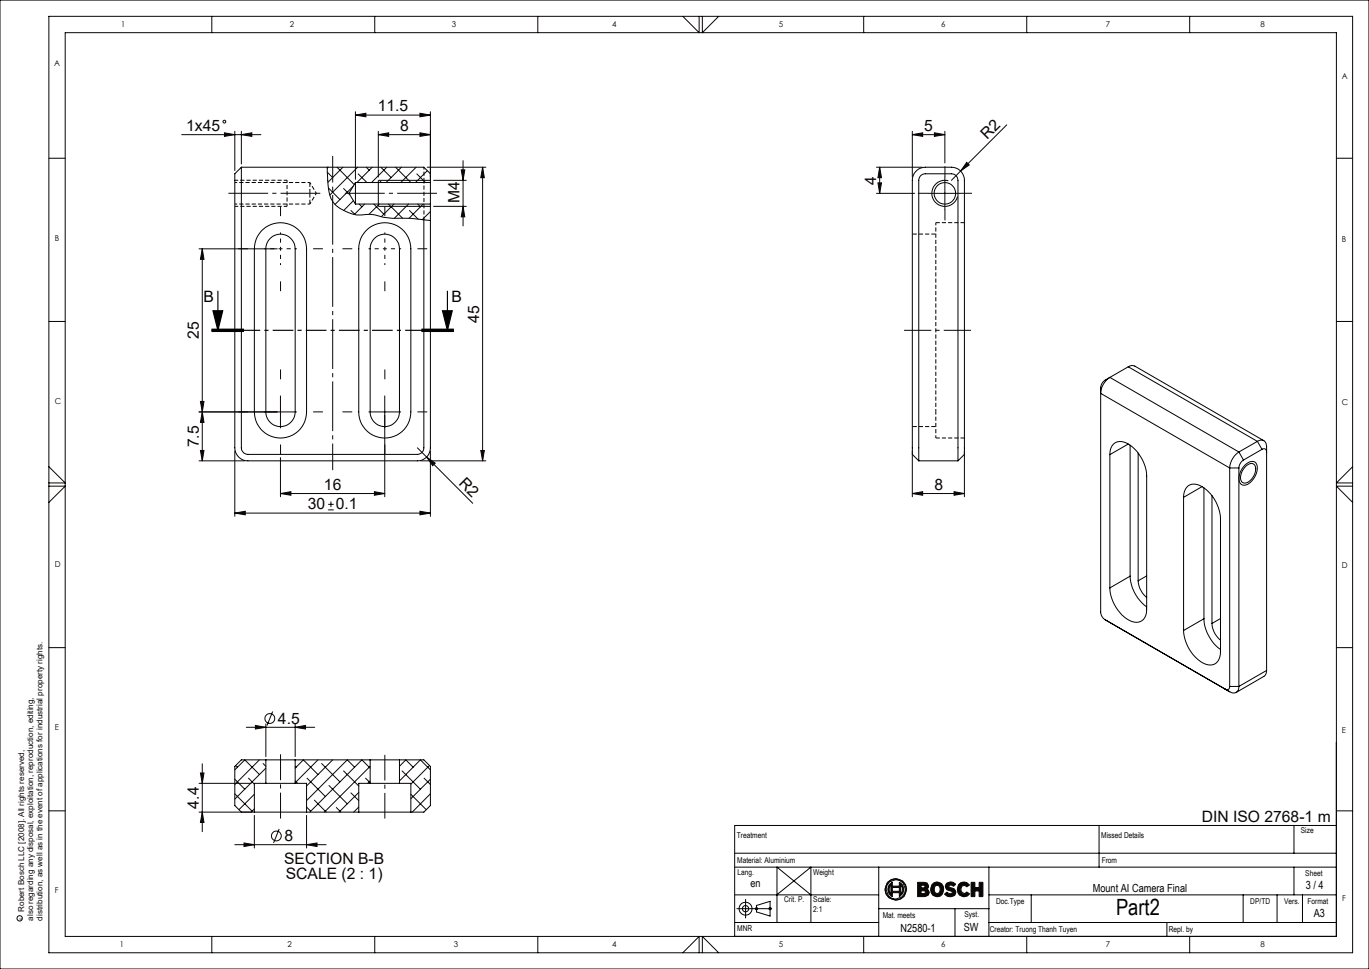
[picture p58: page 3]
SECTION B-B SCALE (2 : 1); DIN ISO 2768-1 m; Missed Details; Material: Aluminium

distribution, as well as in the event of applications for industrial property rights.

also regarding any disposal, exploitation, reproduction, editing,

c Robert Bosch LLC [2008]. All rights reserved,

From
Mount AI Camera Final

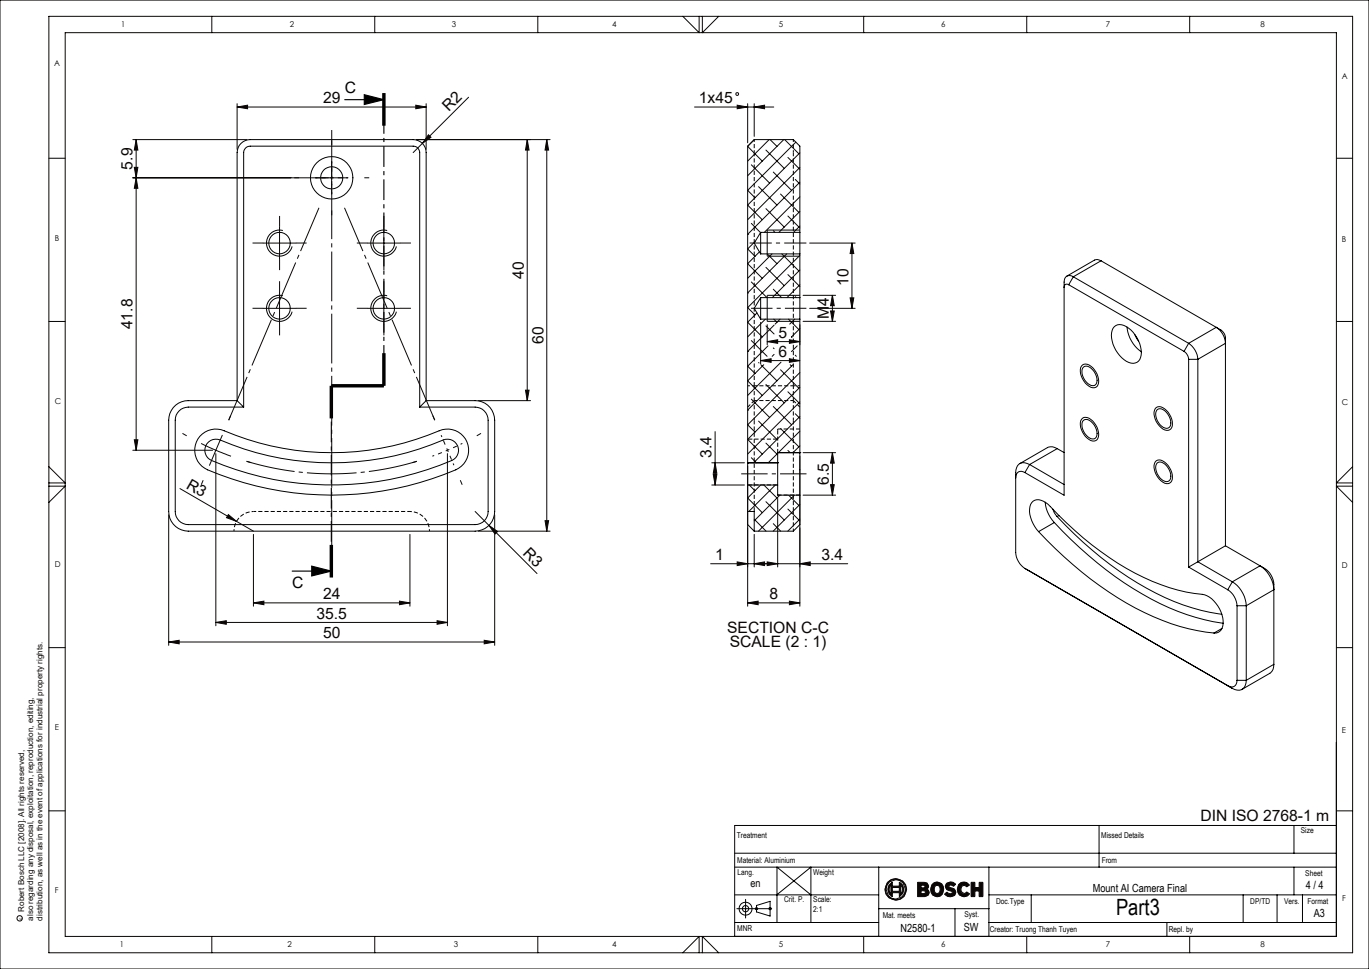
[picture p59: page 4]
SECTION C-C SCALE (2 : 1); DIN ISO 2768-1 m; Missed Details; Material: Aluminium

distribution, as well as in the event of applications for industrial property rights.

also regarding any disposal, exploitation, reproduction, editing,

c Robert Bosch LLC [2008]. All rights reserved,

From
Mount AI Camera Final
