tuyenubuntu/aicabinet/cabinet_cabin_1/Portal_Cabin_1/Mount_AI_camera_OD_v1.pdf

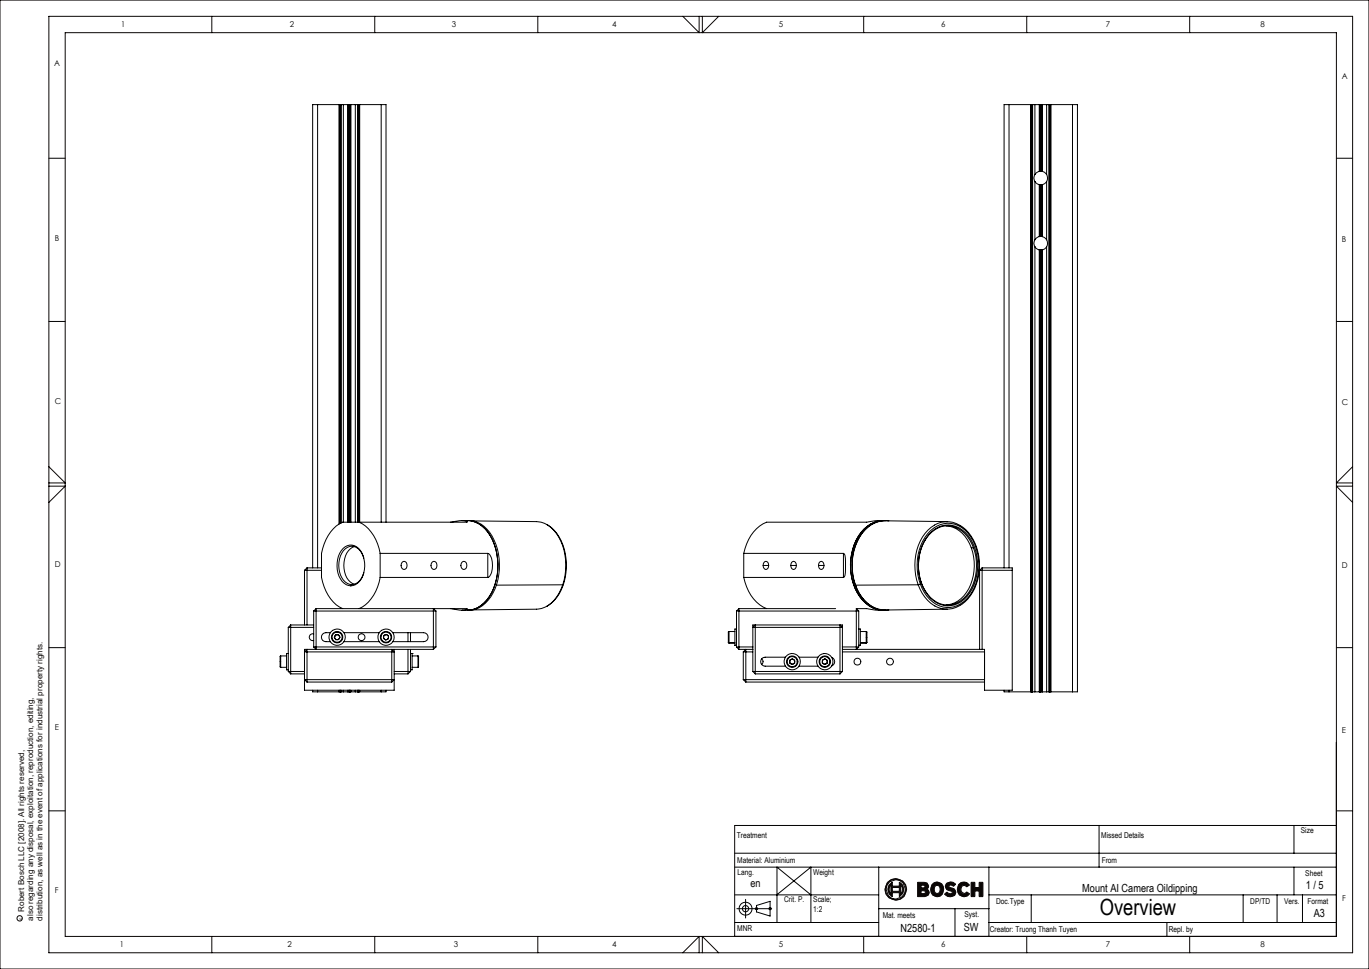
[picture p60: page 1]
Missed Details; Vers. Format; Creator: Truong Thanh Tuyen; Repl. by; Mat. meets; Syst.; Crit. P.; Material: Aluminium

distribution, as well as in the event of applications for industrial property rights.

also regarding any disposal, exploitation, reproduction, editing,

c Robert Bosch LLC [2008]. All rights reserved,

From
Mount AI Camera Oildipping

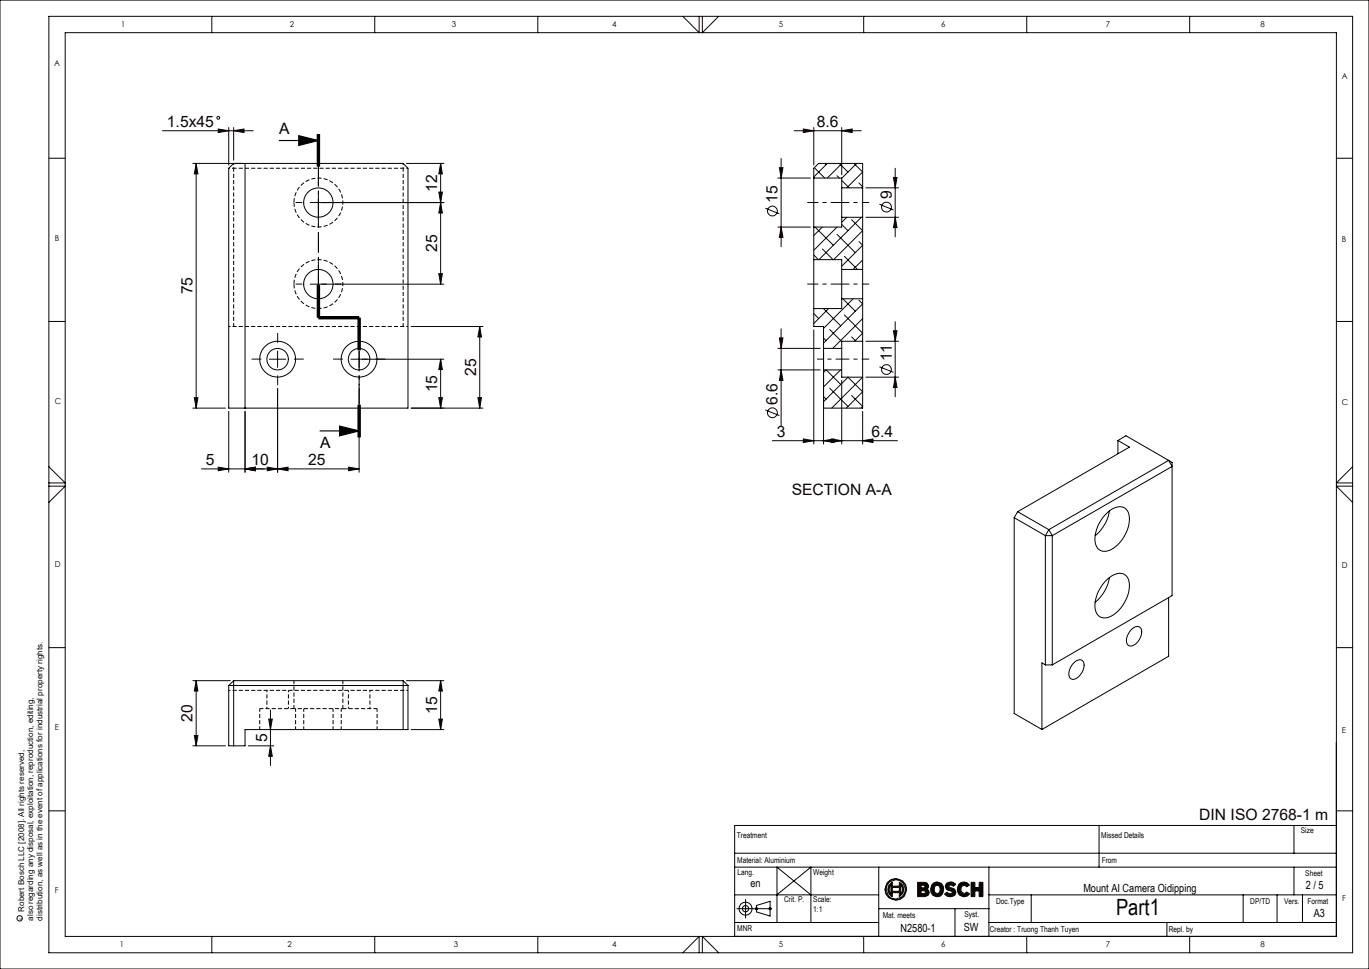
[picture p61: page 2]
SECTION A-A; DIN ISO 2768-1 m; Missed Details; Creator : Truong Thanh Tuyen; Repl. by; Material: Aluminium

distribution, as well as in the event of applications for industrial property rights.

also regarding any disposal, exploitation, reproduction, editing,

c Robert Bosch LLC [2008]. All rights reserved,

From
Mount AI Camera Oidipping

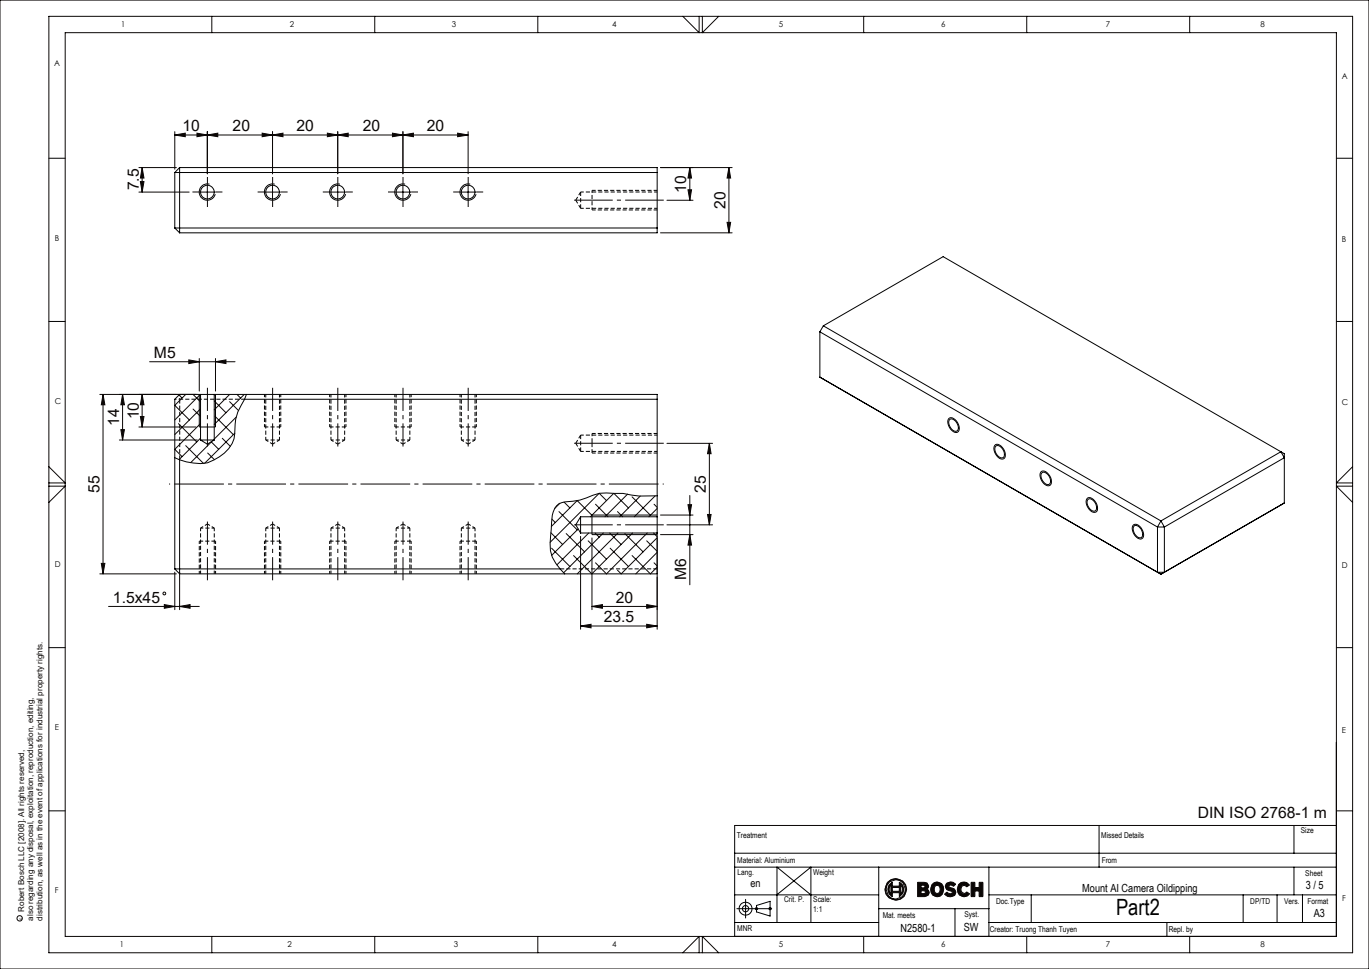
[picture p62: page 3]
DIN ISO 2768-1 m; Missed Details; Material: Aluminium

distribution, as well as in the event of applications for industrial property rights.

also regarding any disposal, exploitation, reproduction, editing,

c Robert Bosch LLC [2008]. All rights reserved,

From
Mount AI Camera Oildipping

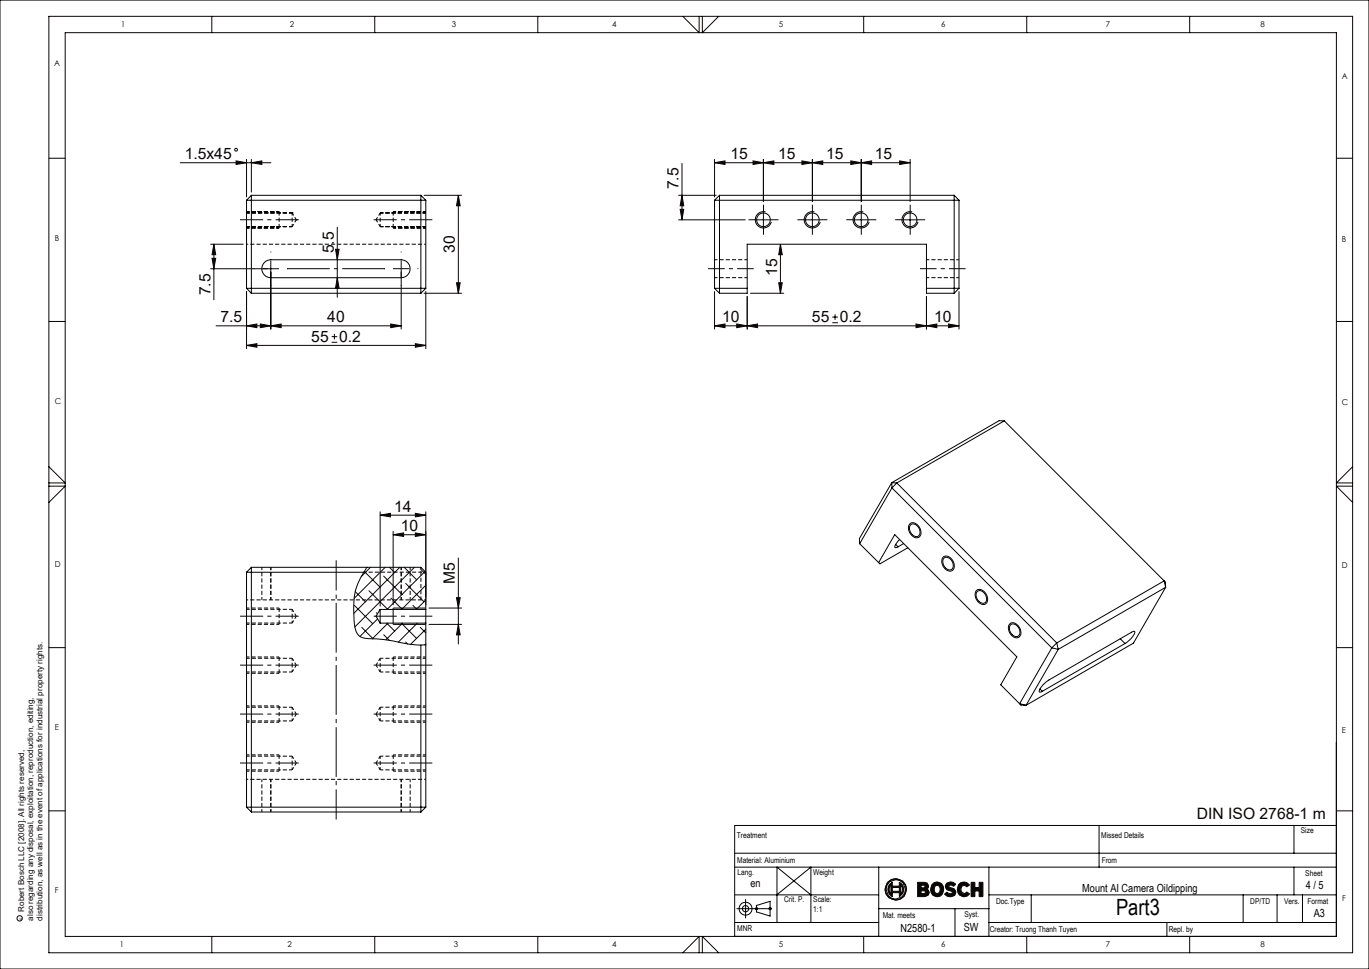
[picture p63: page 4]
DIN ISO 2768-1 m; Missed Details; Material: Aluminium

distribution, as well as in the event of applications for industrial property rights.

also regarding any disposal, exploitation, reproduction, editing,

c Robert Bosch LLC [2008]. All rights reserved,

From
Mount AI Camera Oildipping

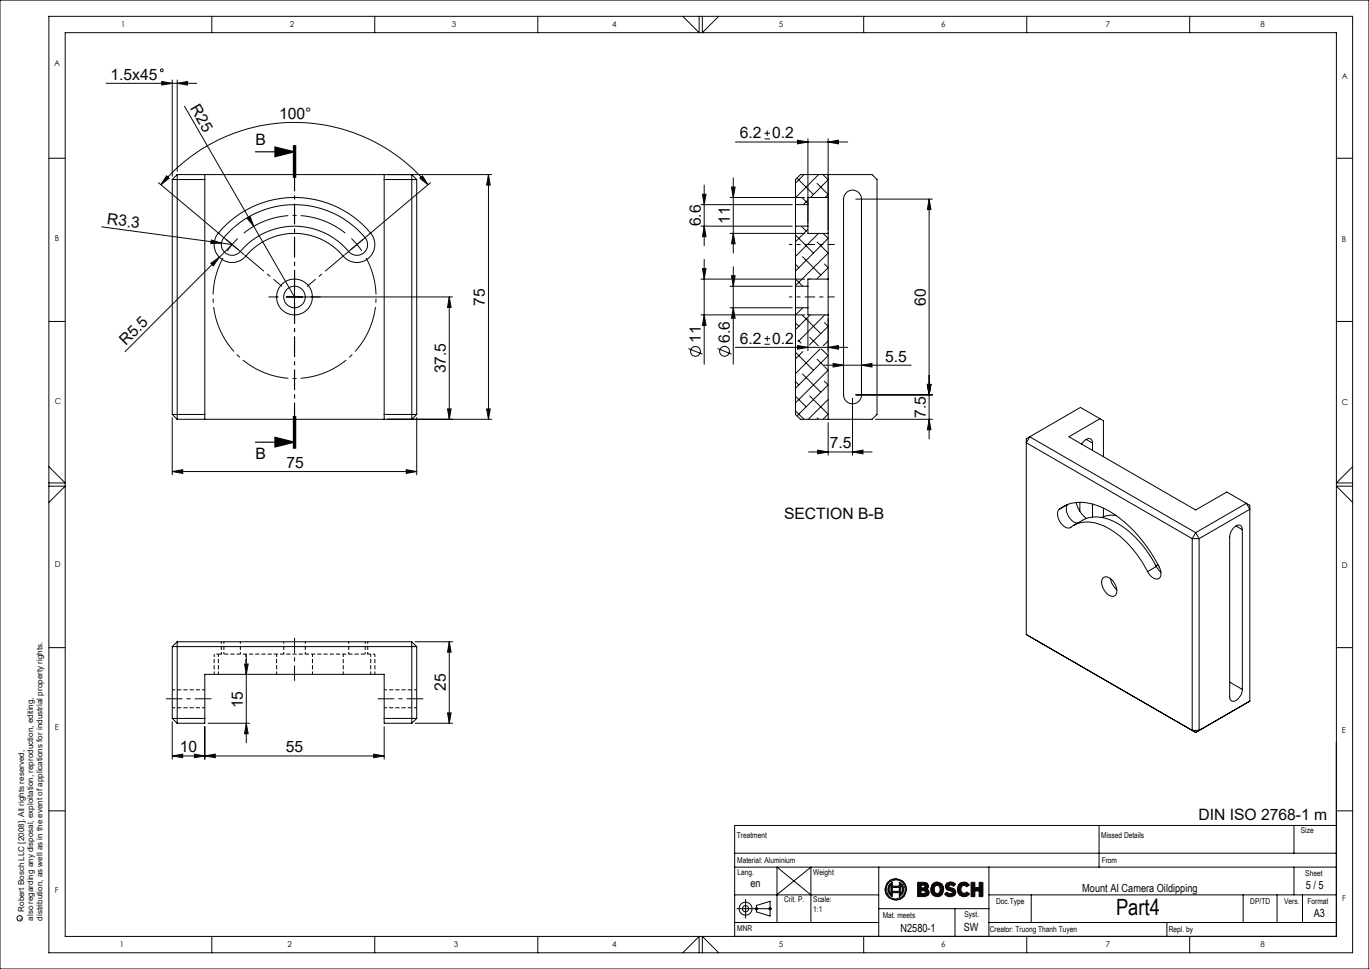
[picture p64: page 5]
SECTION B-B; DIN ISO 2768-1 m; Missed Details; Material: Aluminium

distribution, as well as in the event of applications for industrial property rights.

also regarding any disposal, exploitation, reproduction, editing,

c Robert Bosch LLC [2008]. All rights reserved,

From
Mount AI Camera Oildipping
